Weilv-D/kuafu/docs/architecture/system.md

# System Architecture

## Control Partition

The STM32 owns safety-critical stabilization as a deadline-bounded bare-metal runtime; the Pi5 runs an ONNX Actor at 50 Hz and supplies bounded residual actions. The Actor never replaces the baseline controller. The two exchange a shared contract — Pi5 commands velocity/yaw/D0 plus six normalized residuals, STM32 returns timestamped IMU, joint, and health telemetry — defined in full in `docs/contracts/interface.md`.

```text
high-level command (Pi5)
  -> jerk/acceleration-limited references
  -> STM32 baseline: position, velocity, pitch, heading, roll, IK
  <- Pi5 Actor: bounded common/yaw torque and Qx/D0 residuals
  -> wheel/servo commands
```

The runtime runs on four deadline-bounded layers. Layers 1–3 are paced by the
1 kHz BMI088 gyro data-ready tick; layer 4 is paced by the SysTick wall clock
so that an IMU-path failure never silences diagnostics:

1. **1 kHz IMU layer** — BMI088 sampling and Mahony attitude fusion, never waiting on actuator buses.
2. **250 Hz safety-control layer** — snapshots the newest valid sensor and command state, runs the state machine, then LQR/LQI with reference tracking, yaw heading/rate tracking, and roll leveling.
3. **50 Hz leg/Pi layer** — projects Qx/D0 residuals through five-bar IK onto ST3215 targets, parses Pi traffic, and publishes fusion-state telemetry (IMU/joint frames).
4. **Wall-clock diagnostic layer** — reports fault masks, temperatures, per-device bus ages, error counters, reset cause, and safety mode (250 Hz diagnostic frames, 10 Hz health frames, FAULT frames while latched), independently of the data-ready tick and of IMU health.

A separate `startup_manager` gates actuator power through `WAIT_POWER → IMU_DISCOVERY → ACTUATOR_DISCOVERY → READY` (with a `FAILED` terminal that latches FAULT); gyro bias calibration is deliberately **not** a startup gate — it accumulates in the background while the robot stands, because a zero bias is a valid autonomous STAND starting point. Torque is never enabled merely because initialization began; the system reaches STAND only once every device reports fresh. Wheel torque is a separately armed domain with three baseline conditions — the system operational (STAND/ACTIVE/CLIMB, so INIT keeps the wheels locked to read-only queries), startup READY, and no latched fault — whose loss is immediately revoked; this is independent of the Pi so standalone STAND balance works with no Pi attached. Entering ACTIVE additionally requires a compatible Pi model hash, a fresh heartbeat, and an explicit mode request.

Ten independent fault classes (tilt, pitch rate, overtemperature with 100 ms debounce, IMU loss, left/right wheel loss, servo loss, emergency stop, initialization failure, internal-state fault) latch `FAULT`. They split into two recovery families: **serious** faults (tilt, pitch rate, overtemperature, IMU loss, emergency stop, initialization failure, internal fault) stay latched until power cycle, while the three **transient device faults** (left/right wheel loss, servo loss) auto-recover once the device reports fresh again — recovery re-enters STAND through the supervisor's re-issue stage, which physically re-runs the servo torque enables and requires a transmitted leg hold before wheel output returns. Degradation short of a fault is explicitly asymmetric: a stale action clears only the learned residual, while a stale heartbeat additionally zeroes velocity and yaw commands and returns ACTIVE/CLIMB to STAND, retaining a bounded local position/heading hold so the robot stays still rather than falling.

### Operating Modes

The state machine distinguishes five modes (`INIT`, `STAND`, `ACTIVE`, `CLIMB`, `FAULT`). The LQR/LQI baseline runs whenever the system is operational (STAND/ACTIVE/CLIMB); what changes between them is whether the Pi commands motion and whether the learned residual is added:

| Mode | Wheel torque | Leg D0 (IK) | RL residual | Entered by |
|---|:---:|:---:|:---:|---|
| `INIT` | locked (read-only queries) | — | — | power-on; auto-exits when every device is fresh |
| `STAND` | LQR/LQI **hold** (zero velocity/yaw command) | follows `target_leg_d0` | off | auto, once startup reaches `READY` |
| `ACTIVE` | **LQR/LQI tracking** (follows Pi velocity/yaw) | follows `target_leg_d0` + qx/d0 residual | **on** | Pi requests ACTIVE + compatible hash + fresh heartbeat |
| `CLIMB` | LQR/LQI **hold** (zero velocity/yaw command) | follows `target_leg_d0` | off | Pi requests CLIMB from ACTIVE |
| `FAULT` | zero | torque disabled (one-shot) | — | any fault; transient device faults auto-recover (servo enables re-issued first), serious faults latch until reset |

`ACTIVE` is the only mode in which the learned residual is live, so it is the only mode in which the robot walks. The policy observation is 35-dimensional proprioception with no mode flag; the policy is unaware which mode it runs in, and CLIMB/STAND behaviour comes entirely from the baseline.

A mode request that names a mode the firmware cannot enter is never silently dropped: from a walking mode (`ACTIVE`/`CLIMB`) an `INIT` request is honoured as `STAND`. `INIT` is a boot state with no inbound transition, so a sender that asks for it while the robot moves is asking the robot to stop, and the mode on both sides of the link must agree about that. `CLIMB` stays reachable only through the `ACTIVE` arming step, so a `CLIMB` request from `STAND` leaves the robot holding.

> **`CLIMB` is a reserved placeholder, not a distinct behaviour.** In the firmware it shares the same code path as `STAND` (same pure-D0 IK, same wheel hold, no residual — `main.c` servos the identical virtual-height branch for both). The RL environment has no CLIMB concept: terrain traversal (steps and slopes) is trained as a curriculum axis under the ACTIVE policy using D0/Qx residuals, and the policy never emits or observes a mode. Selecting CLIMB today is therefore functionally equivalent to STAND. A future CLIMB implementation would need coordinated changes in firmware (a distinct servo/wheel policy for the mode), training (a mode-conditioned or separate policy), and the Pi runtime.

Roll leveling applies `ΔD0 = -ROLL_KP·roll - ROLL_KD·ωx` with `ROLL_KP = 190 mm/rad` and `ROLL_KD = 5.0`, a conservative initial value derived from the ~196 mm wheel track. A high-speed D0 gate limits D0 to 120 mm whenever `|v| > 0.3 m/s` or `|w| > 0.6 rad/s`, preventing COM-rise topple. LQR/LQI gains, wheel torque limits, five-bar geometry, and the full normative physical model live in `kuafu_physics.py`; the implementation-level runtime, driver, and safety detail lives in `stm32_firmware/README.md`.

## Learning Partition

The Actor receives four causal 35-dimensional proprioceptive frames, for a 140-dimensional input. Forward velocity and yaw rate come from wheel-odometry estimates, not simulation root truth. Every input has a sensor or estimator counterpart on real hardware. The `prev_applied_action` field carries the delayed action actually sent to actuators, so the policy observes the true effect of its previous output. A training Critic receives the Actor input plus 12 simulation-only values: nine static domain-randomization parameters and the three-dimensional applied push.

Friction domain randomization samples actual coefficients in `[0.3, 1.2]`. Push perturbation uses impulse-based sampling of 0-2 N·s with random timing. The first-frame history on reset is `[0, 0, 0, current]`, seeding the causal window with a valid current observation.

## Policy And Projection

The policy is a reparameterized tanh-squashed diagonal Gaussian:

```text
u ~ Normal(mu, sigma)
a = tanh(u)
log p(a) = log Normal(atanh(a); mu, sigma) - sum(log(1-a^2))
```

The Jacobian term `-log(1-a^2)` is included in `log_prob`, ensuring unbiased PPO ratios and entropy. PPO sampling, deterministic inference, ONNX, and Pi5 use this same transformation. PPO uses `init_noise_std = 0.4`, `gamma = 0.995`, and `num_steps_per_env = 96`. The six bounded actions are projected as common wheel torque, yaw wheel torque, left Qx, left D0, right Qx, and right D0. Qx and D0 are independently mapped through a two-dimensional five-bar IK grid.

## Curriculum

Training drives an 8-axis independent curriculum state machine (`rl/train/curriculum.py`): `command, d0, dr, latency, slope, step, rough, push`. Each axis has independent levels (0-4), evaluated by done-env episode count. Terrain/perturbation axes advance on a pure survival gate; only `command`/`d0` add a tracking anti-cheat gate calibrated to the physical noise floor, so a policy that remains still cannot pass the gate but terrain progress is never blocked on velocity tracking. An axis advances when survival (and, for command/d0, tracking) passes for two consecutive evaluations and regresses on two consecutive failures. Rough terrain is a MuJoCo heightfield rewritten each reset.

## Simulation

MJX advances ten 2 ms physics steps for each policy step. The five 4 ms base updates recompute LQR/LQI wheel torque while holding the policy residual. Native MuJoCo evaluation must use the same command projection and timing before it can be considered a release result.
