Weilv-D/kuafu/CHANGELOG.md

# Changelog

## Unreleased

### Firmware logic review, fifth record (2026-09-20)

An independent eighth-pass, whole-repository review performed from source
alone (the seven prior records consulted only afterwards to cross-check;
their invariants held, and one encoded test expectation was found to pin a
defect). Three findings, all closed in this round.
Record: `docs/validation/stm32-firmware-2026-09-20-5.md`.

- (High) The Pi RX transport recovers from a ring overrun instead of
  stalling one ring behind the producer forever. `pi_transport_poll` derived
  its parse span from a read-index-vs-write-index comparison; after the
  overrun drop the two indices coincide while a full ring is still pending,
  so the poll parsed nothing and every later byte was billed as a fresh
  overrun — the receive side of the Pi link stayed deaf until reboot after
  any main-loop stall longer than one ring (~2.2 ms at 921600 baud). The
  span now comes from the absolute produced/consumed cursors (clamped to one
  ring), the still-valid remainder is parsed in the same poll, and the
  laps/NDTR sampling race is harmless by construction (a stale sample can
  only under-advance the producer for one poll; `consumed` can never
  overshoot `producer`). Regressions in `test_pi_transport.c` (new overrun-
  recovery suite) and one corrected wrap-case expectation in
  `test_pi_link.c`.
- (Medium) The balance trace's post-fault freeze is releasable. Previously
  the first fault — including an auto-recovered transient wheel/servo
  freshness blip — froze the 256-sample ring for the rest of the session, so
  a later crash's window was never recorded. The freeze now releases when a
  new fault arrives after a fault-free period (the newer evidence supersedes
  the preserved window) or once the system has been fault-free for a full
  64-sample tail; a latched serious fault keeps the ring frozen by design.
  Two new file-scope statics (+4 bytes RW) shifted 11 SWD symbol addresses
  by a uniform +4; the `HANDOFF.md` §5.2 table and the three hardcoded
  debug-script ADDR dictionaries were rebased. Regression in
  `test_balance_trace.c`.
- (Low) `lqr_update_elapsed_dt` coasts on any non-finite input instead of
  propagating NaN through the gains into the torque output (NaN compares
  false against every clamp bound, and the dispatch clamps only bound
  magnitude). Unreachable through the current call chain; the guard is for
  future callers, matching `ddsm_build_torque`/`quantize_i16`/
  `servo_angle_to_tick`. Regression in `test_lqr.c`.

### Firmware logic review, fourth record (2026-09-20)

An independent sixth-pass, whole-repository review performed from source
alone (the five prior records consulted only afterwards to cross-check;
nothing in them was stale). Three findings, all closed in this round.
Record: `docs/validation/stm32-firmware-2026-09-20-4.md`.

- (Medium) The firmware receive sequence gate now resynchronizes after a
  peer restart, mirroring the Pi-side decoder's 8-frame resync: eight
  consecutive CRC-valid, non-HELLO frames rejected by the monotonic gate
  alone clear the baseline and the next frame starts a new session. Every
  Pi-side program sends HELLO exactly once at startup, so a single
  corrupted HELLO previously locked a rebooted Pi out of `ACTIVE` until
  its counter climbed back past the previous session's high-water mark —
  minutes at 50 Hz, clearing only on an STM32 power cycle. Payload-invalid
  frames never count (noise cannot open the gate), and any accepted frame
  clears the streak, so isolated duplicates are still dropped. The reject
  counter is packed into the existing `have_rx_sequence` state byte, so
  the SWD debug-symbol table is unchanged. Regression in `test_pi_link.c`.
- (Low) `ddsm_build_torque`/`ddsm_build_speed` decode a non-finite command
  as zero (coast) instead of reaching an undefined float→int cast — a NaN
  compares false against every clamp bound. Unreachable through the
  current call chain (finiteness is validated upstream in the same control
  deadline); the guard is for future callers of the public encoders, the
  same latent-trap class as `quantize_i16`. Regression in
  `test_ddsm315.c`.
- (Low) `servo_angle_to_tick` maps a non-finite angle to the calibrated
  dwell tick instead of the same undefined cast — never a mechanical
  extreme, which a clamp would command. Regression in
  `test_servo_mapping.c`.

### Firmware logic review, third record (2026-09-20)

An independent fifth-pass review performed from source alone (prior
records consulted only afterwards to re-verify their invariants; all held).
Six findings, all closed in this round. Record:
`docs/validation/stm32-firmware-2026-09-20-3.md`.

- (Medium) Both ST3215 write-frame failure paths — a lost TX-complete
  interrupt and a UART error during the write — recover through the same
  explicit transmit abort before the bus returns to IDLE. An error storm is
  precisely when completion interrupts go missing; either path skipping the
  abort can wedge the HAL transmit state at `BUSY_TX` forever (all leg
  writes fail `HAL_BUSY`, the 100 ms leg-hold window expires, the wheel
  gate closes, and the 20 ms deadline backstop is disarmed because phase is
  already IDLE). Regression in `test_st3215.c`.
- (Medium-low) Circular RX-ring re-arms preserve the lap truth: new
  `dma_rx_ring_rebase()` anchors the consumer at the current lap boundary
  while keeping every counted lap and the cumulative overrun diagnostic —
  the same semantics `pi_transport_reset` already implements (the
  synchronous abort completes the old stream, so a racing lap is real).
  The ring is also initialised before the peripheral that starts its DMA.
  A lost or invented lap skews the producer cursor by up to one ring and
  re-feeds overwritten bytes to the parser as spurious checksum failures.
  Regression in `test_dma_rx_ring.c`.
- (Medium-low) Diagnostic, health, and FAULT telemetry ride the SysTick
  wall clock (250 Hz diag, 10 Hz health, FAULT while latched) instead of
  the gyro data-ready tick: an IMU-path failure no longer silences the
  frames that diagnose it. Fusion-state telemetry (IMU/joints) stays
  DRDY-gated — frozen fusion output has no value, and the health frame's
  age fields carry that information. The cadence divider is a `main()`
  stack local, so the SWD symbol table is unchanged.
- (Low) `balance_trace_init()` seeds the first recorded sample with the
  INIT boot marker (the event type existed; nothing produced it).
- (Low) Telemetry quantization returns the zero sentinel for non-finite
  inputs instead of an undefined float-to-int cast; finite encodings are
  unchanged. Regression in `test_pi_link.c`.
- (Low) `pi_link_on_tx_error` carries the `tx_active` guard its completion
  twin has, so an error arriving while nothing of ours is transmitting
  cannot pop a merely queued telemetry frame.

### Firmware logic review, second pass (2026-09-20)

An independent fourth-pass review layered on the 09-20 three-pass baseline
(architecture and every module re-derived from source before the prior
records were consulted). Record: `docs/validation/stm32-firmware-2026-09-20-2.md`.

- Wheel dispatch no longer leaves torque latched in the DDSM315 current
  loop when the output gate closes on a still-enabled wheel: an explicit
  zero-torque frame is sent in any mode (previously only `FAULT`; other
  gate-closed states sent a read query, and the motor kept driving the
  pre-closure LQR torque — reachable via a supervisor HOLDING demotion
  while the mode stayed operational, e.g. the 100 ms leg-hold window
  expiring under servo-bus congestion — until the 45° TILT backstop).
  Torque frames elicit the same status reply as queries, so feedback
  freshness is unchanged in every branch. New regression in
  `test_ddsm315.c` pins the zero-frame encoding and the reply channel.
- `SERVO_FAIL_LIMIT` comment corrected: it is the round-robin poll's
  `offline_after` (3 consecutive read failures mark a servo offline), not a
  fatal-FAULT latch; fault latching belongs to the safety layer's freshness
  path.
- Documented as deliberate (no code change): telemetry is silent while the
  IMU path is down (slots live in the DRDY-gated fusion block — SWD-only
  forensics in that state); the DDSM feedback mode byte is diagnostic-only
  (no runtime re-assert verification); the LQR position estimate freezes
  during gate-closed periods (≤ one 20 ms catch-up step, ~4 cm worst-case
  `x_est` bias for a 100 ms demotion).
- Documentation: HANDOFF repository path updated after the workspace move;
  the dispatch policy is now stated wire-accurately in the safety-gating
  section; this changelog gained the previously missing 09-20 three-pass
  entry below.

### Firmware logic review (2026-09-20, three passes)

Full-codebase review layered on the 09-13/09-16 baselines: two review
passes (the second re-verifying the first's fixes via byte-level echo-filter
traces, FAULT bus-queue priority, a UB audit, and an NVIC priority audit)
plus a closeout pass. 10 defects fixed (1 high, 5 medium, 4 low). Record:
`docs/validation/stm32-firmware-2026-09-20.md`.

- (High) The servo enable sequencer was mode-blind: during `FAULT` it fought
  the 50 Hz one-shot torque-disable (~80 ms enable/disable churn) and re-set
  `servos_enabled`, so a transient-fault recovery could clear the
  supervisor's re-issue stage on the racing 0→1 and reopen the wheel gate on
  physically torque-free legs. The sequencer is now gated on
  `mode != FAULT`, giving the supervisor the genuine drop-and-return its
  re-issue stage requires.
- (Medium) The DDSM bus timeout verdict is re-validated under the IRQ mask
  against phase and deadline, closing the one main-context phase transition
  the concurrency contract left uncovered (a stale verdict could kill a
  transaction the completion ISR had just started).
- (Medium) ST3215 write frames (sync-write/torque) carry a 20 ms deadline
  and recover through an explicit `AbortTransmit`, so a lost TX-complete
  interrupt costs one frame instead of wedging the servo bus until a
  freshness fault.
- (Medium) Servo freshness requires a real first feedback frame: the
  boot-time optimistic online flag could make a never-replied servo look
  fresh for the first second, briefly opening the wheel gate on legs whose
  feedback had never been seen.
- (Medium, bench builds only) The two calibration images latch `FAULT_INIT`
  (serious) in addition to the transient diagnostic bits: a transient bit
  alone auto-recovers to STAND within seconds of the freshly polled devices
  reporting fresh, re-arming actuation on an image that must stay
  torque-free.
- (Medium) The 1 kHz tick block's deep `continue` became an explicit
  `if (g_imu.initialized)` guard — the `continue` silently skipped every
  scheduler stage below it (50 Hz legs, servo poll), coupling them to IMU
  init state.
- (Low) `pi_link` critical sections restore the saved PRIMASK instead of a
  bare `__enable_irq()`; `bmi088_read_temp` gained the handle guard its
  sibling readers have; `queued_mode` no longer records an enable frame's
  CRC as a control mode; the retired `STARTUP_GYRO_CALIBRATION` enum member
  was deleted (numeric gap kept for trace-encoding stability) and dead
  declarations clarified.

### Firmware & Pi5-runtime logic review (2026-09-16)

- The freshness-fault grace window (100 ms + stale-counter reset) is now
  granted only by device-driven mode transitions (INIT->STAND, FAULT->STAND
  recovery). Command-driven transitions (mode requests, link-loss demotion)
  previously reset the counters too, so a Pi flapping `mode_request` at
  >10 Hz could suppress wheel/servo loss faults indefinitely while the
  wheels stayed enabled.
- The 50 Hz leg-write deadline is no longer dropped when the ST3215 bus is
  busy: the pending flag survives until a frame is actually queued (or the
  mode has nothing to send), retried on the next scheduler pass — the same
  retry shape the wheel dispatch always had. Five bus-busy collisions used
  to expire the 100 ms leg-hold window and close the wheel gate (~100 ms of
  zero torque on a balancing robot); with one degraded servo this recurred
  regularly. `firmware_runtime.servo_intent_allowed` is now a pure
  mode-level verdict, symmetric with `wheel_intent_allowed`.
- `teleop_single` mirrors the firmware's dynamic D0 gate before encoding:
  raising the legs and pushing the stick fast used to fail validation every
  tick, silencing the heartbeat stream exactly during aggressive motion
  until the 200 ms watchdog demoted the robot. The TX error path now falls
  back to a safe STAND heartbeat instead of silence, a lost gamepad no
  longer replays its last stick values, a blocking BLE reconnect first
  forces disarm, and the exit ESTOP is flushed before close.
- The Pi-side `StreamDecoder` resynchronizes after a peer sequence restart
  (STM32 reboot restarts its TX counter at 0): 8 consecutive CRC-valid
  sequence-gated rejections clear the high-water mark. Previously every
  telemetry frame was blackholed until the rebooted counter climbed past
  the stored value. Isolated duplicates are still dropped.
- `serial_node` keeps the heartbeat contract with an explicit safe request
  (STAND, zero commands) when telemetry is stale instead of going silent,
  and resets the observation history when telemetry resumes.
- `link_probe` fault-bit table realigned with `safety_state.h` (it was
  shifted one bit — FAULT_SERVO printed as WHEEL_L_LOST); FAULT frames are
  now counted and printed, `--mode` is validated, HEALTH payloads are
  length-guarded, the loop re-clamps its deadline after a stall, and the
  exit ESTOP is flushed.
- Diag telemetry saturates the temperature into the uint8 field (a negative
  BMI088 reading was an undefined float-to-unsigned cast).
- Removed the dead `gyro_calibrated` input plumbing from
  `SafetyInputs_t`/`StartupInputs_t`/`ControlSectionInputs_t` (never
  consumed anywhere; gyro calibration is documented as a non-gate).

### Firmware logic review (2026-09-13)

- Fixed an initial-power-on deadlock in the actuator supervisor's ops-less
  enable-reissue stage: the scheduler couples `startup_ready` and
  `servo_enable_verified` to the same sequencer variable, so the verified flag
  is never observed low while `startup_ready` is high, and the unconditional
  clearing of `enable_verified_observed_low` on every STARTUP/HOLDING entry
  discarded the boot-time low observations. The wheel-output gate could never
  open from a clean boot (only a prior FAULT cycle unblocked it). Low-state
  observations are now latched on every step, and the drop-requirement is
  re-armed only when a revocation follows an authorized (READY) state;
  transient leg-readiness gaps no longer re-arm it.
- Wheel enable no longer occurs while the safety mode is still `INIT`; the
  wheel power domain stays locked to read-only queries until STAND, matching
  the documented mode table.
- ST3215 UART error handling is deferred from the error ISR to the main-loop
  bus step, eliminating an interrupt-context race on the transaction pointer,
  phase, parser, and health counters (the DDSM driver already used locking;
  this bus now uses deferral).
- The 64-byte RAM-top forensic dump area (`STALL_DUMP` + `FAULT_DUMP`) is now
  excluded from the linker layout (IRAM2 ends at `0x2001FFBF`), so future RAM
  growth can never collide with the reset-surviving dumps.
- LQR estimation authority now additionally requires IMU pair freshness, so a
  dead gyro data-ready line (which freezes `g_imu_control_valid` at its last
  value) revokes torque at the 20 ms freshness bound instead of the ~52 ms
  freshness-fault debounce.
- Removed the unconsumed `firmware_runtime.clear_motion` output (motion
  clearing is owned by the safety state machine) and duplicate dead
  trace-validity defines in `main.c`.
- Documentation aligned: schema references updated to `v1.2.0`, the startup
  chain no longer lists the unused GYRO_CALIBRATION phase, the wheel-domain
  gating text matches the standalone-STAND design, and stale DDSM timeout /
  debounce numbers corrected (12 ms / 8 ticks).

### Control and contract

- Versioned 140-dimensional Actor / 152-dimensional Critic contract at schema `v1.1.0`, with a tanh-squashed policy transform shared by PPO, ONNX export, and the Pi5 runtime.
- Source-generated discrete LQR/LQI firmware constants, dwell-relative five-bar IK generation, and versioned UART framing with CRC-8/MAXIM.
- High-speed D0 gate (120 mm cap when `|v| > 0.3 m/s` or `|w| > 0.6 rad/s`) and roll leveling (`ROLL_KP = 190 mm/rad`, `ROLL_KD = 5.0`).

### Firmware

- STM32F407ZG bare-metal runtime: 1 kHz IMU fusion, 250 Hz LQR/LQI baseline, five-bar workspace projection.
- Self-balancing in STAND mode works standalone (no Pi required): wheel torque authorization is gated on startup completion and absence of fault, independent of Pi link or heartbeat freshness. The Pi link gates ACTIVE motion commands only.
- LQR control runs every 250 Hz deadline regardless of DDSM bus state; the dispatch layer skips transmission when the bus is busy so the controller is never starved.
- DDSM115 speed feedback decoded in 0.1 RPM units matching the command encoding.
- DDSM transaction timeout set to 12 ms and freshness-fault debounce to 8 ticks to accommodate marginal RS485 links without spurious FAULT_WHEEL.
- Right DDSM315 motor is physically mirrored: `WHEEL_DIR_R = -1` and the LQR yaw-differential formula is adapted so forward torque + positive yaw produce a correct right turn.
- DDSM315 torque polarity is opposite to the cart-pole convention; LQR output is negated accordingly.
- Pitch-gated torque fade (20°→50° linear) prevents wheels spinning at full power when the robot is beyond recoverable tilt; anti-windup zeros the position integral at 50°.
- Wheel dispatch streams zero-torque frames whenever the output gate is
  closed on an enabled wheel (any mode), ensuring the current loop actually
  stops instead of holding its last setpoint; read queries are used only
  while the wheels are disabled.
- BMI088 initialization retries with I2C bus recovery (9 SCL clocks per AN3273) on failure; a soft reset no longer requires a power-cycle for the IMU to come online.
- USART ORE/NE/FE sub-error diagnostics surfaced in DeviceHealth for SWD readout; the 46-byte health telemetry payload is unchanged.
- Pi link auto-accepts the first well-formed heartbeat as proof of protocol compatibility when no explicit HELLO has been received.

### Teleop

- Two-state arm/disarm safety model: sources start DISARMED (firmware STAND, balance held, no motion commands) and require an explicit arm action before the wheels track commands.
- Stick input shaping (deadzone then square curve) and trigger deadzones; full STAND/ACTIVE/FAULT intent carried end to end over the wire.
- Gamepad hot-plug and haptic feedback on state transitions.
- ``--no-policy`` mode for baseline-only operation: skips ONNX loading, sends zero
  residual, requires no ``policy.onnx`` or manifest. Usable with or without teleop.

### Runtime and tests

- Pi5 ONNX Actor loop with manifest, schema, and calibration-table digest validation.
- Release-gate validation, atomic schema-aware checkpoints with CPU-first loading.
- Host test suites: firmware C tests (CMake), teleop Python tests, and contract tests.
- Documentation reorganized around architecture, contracts, operations, validation, and hardware calibration.

### Compatibility

- Schema `v1.0.0` checkpoints (157-dimensional RMA) are `legacy-v0` and cannot be resumed, exported, or deployed.
