Weilv-D/kuafu/stm32_firmware/MDK-ARM/debug_tools/read_health.py

"""Read firmware health records over SWD without writing target memory."""

import argparse
import re
import struct
import time
from pathlib import Path

PROBE = "LU_2022_8888"
TARGET = "stm32f407zgtx"
MAP_PATH = Path(__file__).resolve().parents[1] / "stm32_firmware" / "stm32_firmware.map"


def symbol_address(name: str) -> int:
    text = MAP_PATH.read_text(encoding="utf-8", errors="replace")
    match = re.search(rf"^\s+{re.escape(name)}\s+(0x[0-9a-fA-F]+)\s+Data\b", text, re.MULTILINE)
    if match is None:
        raise RuntimeError(f"cannot find {name} in {MAP_PATH}")
    return int(match.group(1), 16)


def decode_health(data: bytes, offset: int) -> dict[str, int]:
    last, timeout, checksum, protocol, overrun, noise, framing, consecutive, online = \
        struct.unpack_from("<IHHHHHHBB", data, offset)
    return {"last": last, "timeout": timeout, "checksum": checksum,
            "protocol": protocol, "consecutive": consecutive, "online": online,
            "overrun": overrun, "noise": noise, "framing": framing}


def main() -> None:
    parser = argparse.ArgumentParser(description="Read-only KUAFU firmware health over DAPLink")
    parser.add_argument("--samples", type=int, default=5)
    parser.add_argument("--interval", type=float, default=0.5)
    parser.add_argument("--frequency", type=int, default=100_000)
    parser.add_argument("--under-reset", action="store_true",
                        help="explicitly reset during attach; default attaches without reset")
    args = parser.parse_args()

    from pyocd.core.helpers import ConnectHelper

    addresses = {name: symbol_address(name) for name in
                 ("g_system_ticks", "uwTick", "g_imu", "g_ddsm_left", "g_ddsm_right", "g_servos", "g_safety_state", "g_startup_manager", "g_actuator_discovery_step", "g_actuator_configured")}
    addresses["g_st3215_bus"] = symbol_address("g_st3215_bus")
    addresses["huart3"] = symbol_address("huart3")
    addresses["g_ddsm_bus"] = symbol_address("g_ddsm_bus")
    addresses["huart2"] = symbol_address("huart2")
    addresses["hi2c1"] = symbol_address("hi2c1")
    session = ConnectHelper.session_with_chosen_probe(
        blocking=False, unique_id=PROBE, target_override=TARGET, frequency=args.frequency)
    if session is None:
        raise SystemExit("DAPLink probe not found")
    if args.under_reset:
        session.options.set("connect_mode", "under-reset")
    session.open()
    try:
        session.target.resume()
        for _ in range(args.samples):
            # Halt only for the SWD snapshot so all timestamps share one timebase;
            # resume before printing/sleeping to avoid disturbing the watchdog.
            session.target.halt()
            tick = session.target.read32(addresses["g_system_ticks"])
            mode = session.target.read8(addresses["g_safety_state"])
            fault = session.target.read32(addresses["g_safety_state"] + 12)
            startup = bytes(session.target.read_memory_block8(addresses["g_startup_manager"], 12))
            actuator_step = session.target.read8(addresses["g_actuator_discovery_step"])
            actuator_configured = session.target.read8(addresses["g_actuator_configured"])
            imu = bytes(session.target.read_memory_block8(addresses["g_imu"], 0x34))
            left = bytes(session.target.read_memory_block8(addresses["g_ddsm_left"], 0x28))
            right = bytes(session.target.read_memory_block8(addresses["g_ddsm_right"], 0x28))
            servos = bytes(session.target.read_memory_block8(addresses["g_servos"], 4 * 0x34))
            servo_bus = bytes(session.target.read_memory_block8(addresses["g_st3215_bus"], 0x138))
            uart3 = bytes(session.target.read_memory_block8(addresses["huart3"], 0x44))
            wheel_bus = bytes(session.target.read_memory_block8(addresses["g_ddsm_bus"], 0x24))
            uart2 = bytes(session.target.read_memory_block8(addresses["huart2"], 0x44))
            i2c1 = bytes(session.target.read_memory_block8(addresses["hi2c1"], 0x54))
            hal_tick = session.target.read32(addresses["uwTick"])
            records = [("imu", decode_health(imu, 0x20)),
                       ("wheel_l", decode_health(left, 0x14)),
                       ("wheel_r", decode_health(right, 0x14))]
            records += [(f"servo_{i + 1}", decode_health(servos, i * 0x34 + 0x20)) for i in range(4)]
            session.target.resume()
            print(f"drdy_tick={tick} hal_ms={hal_tick} mode={mode} fault=0x{fault:08x}")
            startup_phase, startup_since, startup_next = struct.unpack_from("<III", startup)
            print(f"  startup  phase={startup_phase} since_ms={startup_since} next_ms={startup_next} "
                  f"actuator_step={actuator_step} configured={actuator_configured}")
            accel = struct.unpack_from("<3f", imu, 0x04)
            gyro = struct.unpack_from("<3f", imu, 0x10)
            print(f"  bmi088   initialized={imu[0x31]} init_state={imu[0x30]} "
                  f"temp_c={struct.unpack_from('<f', imu, 0x1C)[0]:.1f} "
                  f"accel=({accel[0]:.3f},{accel[1]:.3f},{accel[2]:.3f}) "
                  f"gyro=({gyro[0]:.4f},{gyro[1]:.4f},{gyro[2]:.4f})")
            print(f"  i2c1     state=0x{i2c1[0x3D]:02x} mode=0x{i2c1[0x3E]:02x} "
                  f"error=0x{struct.unpack_from('<I', i2c1, 0x40)[0]:08x} "
                  f"device=0x{struct.unpack_from('<I', i2c1, 0x44)[0]:02x}")
            print(f"  st_bus   phase={servo_bus[0x134]} tx_len={servo_bus[0x68]} "
                  f"echo={servo_bus[0xC9]} frame={servo_bus[0x12A]}/{servo_bus[0x12B]} "
                  f"rx=0x{servo_bus[0x12C]:02x} uart_rx_left={struct.unpack_from('<H', uart3, 0x2E)[0]} "
                  f"uart_state=0x{uart3[0x3E]:02x} uart_error=0x{struct.unpack_from('<I', uart3, 0x40)[0]:08x}")
            print(f"  ddsm_bus phase={wheel_bus[0x20]} target=0x{struct.unpack_from('<I', wheel_bus, 4)[0]:08x} "
                  f"rx={wheel_bus[0x12:0x1C].hex()} uart_rx_left={struct.unpack_from('<H', uart2, 0x2E)[0]} "
                  f"uart_state=0x{uart2[0x3E]:02x} uart_error=0x{struct.unpack_from('<I', uart2, 0x40)[0]:08x}")
            for name, health in records:
                age = "never" if health["last"] == 0 else str((hal_tick - health["last"]) & 0xFFFFFFFF)
                errors = health["timeout"] + health["checksum"] + health["protocol"]
                uart_sub = ""
                if name.startswith("wheel"):
                    uart_sub = (f" overrun={health['overrun']} noise={health['noise']} "
                                f"framing={health['framing']}")
                temp = ""
                if name.startswith("servo_"):
                    index = int(name[-1]) - 1
                    temp = f" temp_c={struct.unpack_from('<f', servos, index * 0x34 + 0x10)[0]:.1f}"
                print(f"  {name:8s} online={health['online']} age_ms={age:>5} "
                      f"errors={errors} consecutive={health['consecutive']}{uart_sub}{temp}")
            time.sleep(args.interval)
    finally:
        session.close()


if __name__ == "__main__":
    main()
