Weilv-D/kuafu/stm32_firmware/tests/test_safety_state.c

#include "pin_config.h"
#include "safety_state.h"
#include "test_support.h"

#include <math.h>
#include <string.h>

static SafetyInputs_t healthy_inputs(void) {
    SafetyInputs_t inputs;
    memset(&inputs, 0, sizeof(inputs));
    inputs.now_ms = 100U;
    inputs.startup_ready = 1U;
    inputs.imu_fresh = 1U;
    inputs.wheel_l_fresh = 1U;
    inputs.wheel_r_fresh = 1U;
    inputs.servos_fresh = 1U;
    inputs.link_compatible = 1U;
    inputs.heartbeat_fresh = 1U;
    inputs.action_fresh = 1U;
    inputs.requested_mode = STATE_STAND;
    return inputs;
}

static void enter_stand(SafetyInputs_t *inputs) {
    safety_state_init();
    (void)safety_state_update(inputs);
    TEST_EQ_INT(STATE_STAND, g_safety_state.current_mode);
}

static void expect_immediate_fault(SafetyInputs_t inputs, FaultMask_t fault) {
    SafetyInputs_t healthy = healthy_inputs();
    SafetyDecision_t decision;
    enter_stand(&healthy);
    decision = safety_state_update(&inputs);
    (void)decision;
    TEST_EQ_INT(STATE_FAULT, g_safety_state.current_mode);
    TEST_TRUE((g_safety_state.fault_mask & fault) != 0U);
}

static void expect_freshness_fault_after_debounce(SafetyInputs_t inputs,
                                                  FaultMask_t fault) {
    SafetyInputs_t healthy = healthy_inputs();
    enter_stand(&healthy);

    /* Move past the mode-transition grace window so the debounce logic is
     * actually exercised. */
    inputs.now_ms = g_safety_state.mode_grace_until_ms + 1U;

    /* One stale tick does NOT latch. */
    (void)safety_state_update(&inputs);
    TEST_EQ_INT(STATE_STAND, g_safety_state.current_mode);
    TEST_TRUE((g_safety_state.fault_mask & fault) == 0U);

    /* Repeat until just before the debounce threshold. */
    for (uint8_t i = 1U; i < SAFETY_FRESHNESS_DEBOUNCE_TICKS - 1U; ++i) {
        inputs.now_ms += 4U;
        (void)safety_state_update(&inputs);
        TEST_EQ_INT(STATE_STAND, g_safety_state.current_mode);
    }

    /* One more stale tick at the threshold latches. */
    inputs.now_ms += 4U;
    (void)safety_state_update(&inputs);
    TEST_EQ_INT(STATE_FAULT, g_safety_state.current_mode);
    TEST_TRUE((g_safety_state.fault_mask & fault) != 0U);
}

void run_safety_state_tests(void) {
    SafetyInputs_t inputs = healthy_inputs();
    SafetyDecision_t decision;

    enter_stand(&inputs);
    inputs.requested_mode = STATE_ACTIVE;
    decision = safety_state_update(&inputs);
    TEST_EQ_INT(STATE_ACTIVE, g_safety_state.current_mode);
    TEST_TRUE(!decision.enter_hold);

    inputs.action_fresh = 0U;
    decision = safety_state_update(&inputs);
    TEST_TRUE(decision.clear_action);
    TEST_EQ_INT(STATE_ACTIVE, g_safety_state.current_mode);

    inputs.heartbeat_fresh = 0U;
    decision = safety_state_update(&inputs);
    TEST_TRUE(decision.enter_hold);
    TEST_EQ_INT(STATE_STAND, g_safety_state.current_mode);

    inputs = healthy_inputs(); inputs.pitch_rad = SAFETY_MAX_PITCH_RAD + 0.01f;
    expect_immediate_fault(inputs, FAULT_TILT);
    inputs = healthy_inputs(); inputs.pitch_rate_rads = SAFETY_MAX_PITCH_RATE_RAD_S + 0.01f;
    expect_immediate_fault(inputs, FAULT_PITCH_RATE);
    TEST_TRUE((safety_state_legacy_fault_mask() & 0x80U) != 0U);
    inputs = healthy_inputs();
    enter_stand(&inputs);
    inputs.max_temp_c = SAFETY_MAX_TEMP_C + 1.0f;
    inputs.now_ms = 200U;
    (void)safety_state_update(&inputs);
    TEST_EQ_INT(STATE_STAND, g_safety_state.current_mode);
    inputs.now_ms = 299U;
    (void)safety_state_update(&inputs);
    TEST_EQ_INT(STATE_STAND, g_safety_state.current_mode);
    inputs.now_ms = 300U;
    (void)safety_state_update(&inputs);
    TEST_EQ_INT(STATE_FAULT, g_safety_state.current_mode);
    TEST_TRUE((g_safety_state.fault_mask & FAULT_OVERTEMP) != 0U);
    inputs = healthy_inputs(); inputs.imu_fresh = 0U;
    expect_freshness_fault_after_debounce(inputs, FAULT_IMU);
    inputs = healthy_inputs(); inputs.wheel_l_fresh = 0U;
    expect_freshness_fault_after_debounce(inputs, FAULT_WHEEL_LEFT);
    inputs = healthy_inputs(); inputs.wheel_r_fresh = 0U;
    expect_freshness_fault_after_debounce(inputs, FAULT_WHEEL_RIGHT);
    inputs = healthy_inputs(); inputs.servos_fresh = 0U;
    expect_freshness_fault_after_debounce(inputs, FAULT_SERVO);

    safety_state_init();
    inputs = healthy_inputs();
    inputs.requested_mode = STATE_FAULT;
    (void)safety_state_update(&inputs);
    TEST_TRUE((g_safety_state.fault_mask & FAULT_EMERGENCY) != 0U);

    safety_state_init();
    g_safety_state.current_mode = (RobotMode_t)99;
    inputs = healthy_inputs();
    (void)safety_state_update(&inputs);
    TEST_TRUE((g_safety_state.fault_mask & FAULT_INTERNAL) != 0U);

    safety_state_init();
    for (int i = 0; i < 1000; ++i) {
        safety_state_gyro_calib_update(0.01f, -0.02f, 0.03f, (uint32_t)i);
    }
    TEST_TRUE(g_safety_state.is_gyro_calibrated);
    TEST_NEAR(0.01f, g_safety_state.gyro_calib_offset[0], 1.0e-5f);
    TEST_NEAR(-0.02f, g_safety_state.gyro_calib_offset[1], 1.0e-5f);
    TEST_NEAR(0.03f, g_safety_state.gyro_calib_offset[2], 1.0e-5f);
    TEST_EQ_INT(STATE_INIT, g_safety_state.current_mode);

    /* Moving samples are skipped, not reset: scattered still samples still
     * accumulate (bounded by the sample-gap guard). */
    safety_state_init();
    for (int i = 0; i < 500; ++i) {
        safety_state_gyro_calib_update(0.01f, 0.01f, 0.01f, (uint32_t)i);
    }
    for (int i = 0; i < 500; ++i) {
        safety_state_gyro_calib_update(0.5f, 0.0f, 0.0f, (uint32_t)(500 + i));
    }
    for (int i = 0; i < 499; ++i) {
        safety_state_gyro_calib_update(0.01f, 0.01f, 0.01f, (uint32_t)(1000 + i));
    }
    TEST_TRUE(!g_safety_state.is_gyro_calibrated);   /* 999 still < 1000 */
    safety_state_gyro_calib_update(0.01f, 0.01f, 0.01f, 1499U);
    TEST_TRUE(g_safety_state.is_gyro_calibrated);     /* 1000th still sample */
    TEST_NEAR(0.01f, g_safety_state.gyro_calib_offset[0], 1.0e-5f);

    /* A >50 ms sample gap restarts the window: stale and fresh samples must
     * not average together across a real interruption. */
    safety_state_init();
    for (int i = 0; i < 600; ++i) {
        safety_state_gyro_calib_update(0.01f, 0.01f, 0.01f, (uint32_t)i);
    }
    for (int i = 0; i < 600; ++i) {
        safety_state_gyro_calib_update(0.01f, 0.01f, 0.01f, (uint32_t)(1000 + i));
    }
    TEST_TRUE(!g_safety_state.is_gyro_calibrated);   /* gap reset: only 600 */

    /* A constantly moving robot never completes calibration. */
    safety_state_init();
    for (int i = 0; i < 2000; ++i) {
        safety_state_gyro_calib_update(0.1f, -0.2f, 0.3f, (uint32_t)i);
    }
    TEST_TRUE(!g_safety_state.is_gyro_calibrated);

    /* --- Grace window on mode transition --- */
    safety_state_init();
    inputs = healthy_inputs();
    (void)safety_state_update(&inputs);           /* INIT -> STAND */
    TEST_EQ_INT(STATE_STAND, g_safety_state.current_mode);
    TEST_TRUE(g_safety_state.mode_grace_until_ms > 0U);

    /* Within grace window, a single stale IMU tick does not latch. */
    inputs.now_ms = 101U;
    inputs.imu_fresh = 0U;
    (void)safety_state_update(&inputs);
    TEST_EQ_INT(STATE_STAND, g_safety_state.current_mode);
    TEST_TRUE((g_safety_state.fault_mask & FAULT_IMU) == 0U);

    /* After grace expires, debounce still applies. */
    inputs.now_ms = g_safety_state.mode_grace_until_ms + 1U;
    for (uint8_t i = 0; i < SAFETY_FRESHNESS_DEBOUNCE_TICKS; ++i) {
        (void)safety_state_update(&inputs);
    }
    TEST_EQ_INT(STATE_FAULT, g_safety_state.current_mode);
    TEST_TRUE((g_safety_state.fault_mask & FAULT_IMU) != 0U);

    /* A serious fault arriving during transient recovery is combined and
     * remains latched; it must not be erased by the transient clear path. */
    safety_state_init();
    inputs = healthy_inputs();
    enter_stand(&inputs);
    inputs.now_ms = g_safety_state.mode_grace_until_ms + 1U;
    inputs.wheel_l_fresh = 0U;   /* transient device fault, debounced */
    for (uint8_t i = 0U; i < SAFETY_FRESHNESS_DEBOUNCE_TICKS; ++i) {
        (void)safety_state_update(&inputs);
        inputs.now_ms += 4U;
    }
    TEST_EQ_INT(STATE_FAULT, g_safety_state.current_mode);
    TEST_TRUE((g_safety_state.fault_mask & FAULT_WHEEL_LEFT) != 0U);
    /* The transient recovers in the SAME update that reports a new serious
     * tilt fault: the new fault must be merged, never dropped by the recovery
     * branch (the original bug returned STAND here for one cycle). */
    inputs.wheel_l_fresh = 1U;
    inputs.pitch_rad = SAFETY_MAX_PITCH_RAD + 0.2f;
    (void)safety_state_update(&inputs);
    TEST_TRUE((g_safety_state.fault_mask & FAULT_TILT) != 0U);
    TEST_EQ_INT(STATE_FAULT, g_safety_state.current_mode);
    /* Serious faults stay latched after the condition disappears. */
    inputs.pitch_rad = 0.0f;
    (void)safety_state_update(&inputs);
    TEST_EQ_INT(STATE_FAULT, g_safety_state.current_mode);
    TEST_TRUE((g_safety_state.fault_mask & FAULT_TILT) != 0U);

    /* Non-finite physical inputs are safety faults, never silently accepted. */
    inputs = healthy_inputs();
    inputs.pitch_rad = NAN;
    expect_immediate_fault(inputs, FAULT_TILT);
    inputs = healthy_inputs();
    inputs.pitch_rate_rads = INFINITY;
    expect_immediate_fault(inputs, FAULT_PITCH_RATE);
    inputs = healthy_inputs();
    inputs.max_temp_c = NAN;
    expect_immediate_fault(inputs, FAULT_OVERTEMP);

    /* Hard faults still latch even during the grace window. */
    safety_state_init();
    inputs = healthy_inputs();
    (void)safety_state_update(&inputs);           /* INIT -> STAND, grace active */
    inputs.now_ms = 101U;
    inputs.pitch_rad = SAFETY_MAX_PITCH_RAD + 0.1f;
    (void)safety_state_update(&inputs);
    TEST_EQ_INT(STATE_FAULT, g_safety_state.current_mode);
    TEST_TRUE((g_safety_state.fault_mask & FAULT_TILT) != 0U);

    /* A Pi flapping mode requests must not suppress freshness faults: only
     * the device-driven transitions (INIT->STAND, FAULT->STAND) reset the
     * stale counters and re-open the grace window.  Command-driven
     * transitions (STAND<->ACTIVE, link-loss demotion) change no device
     * state, so before this rule a >10 Hz mode flap kept the grace window
     * permanently open and wheel/servo loss faults never latched. */
    safety_state_init();
    inputs = healthy_inputs();
    enter_stand(&inputs);                          /* INIT->STAND: grace granted */
    inputs.now_ms = g_safety_state.mode_grace_until_ms + 1U; /* grace expired */
    inputs.wheel_l_fresh = 0U;
    for (uint8_t i = 0U; i < SAFETY_FRESHNESS_DEBOUNCE_TICKS - 1U; ++i) {
        inputs.now_ms += 4U;
        inputs.requested_mode = (i & 1U) ? (uint8_t)STATE_ACTIVE
                                         : (uint8_t)STATE_STAND;
        (void)safety_state_update(&inputs);
    }
    inputs.now_ms += 4U;
    inputs.requested_mode = (uint8_t)STATE_STAND;
    (void)safety_state_update(&inputs);
    TEST_EQ_INT(STATE_FAULT, g_safety_state.current_mode);
    TEST_TRUE((g_safety_state.fault_mask & FAULT_WHEEL_LEFT) != 0U);

    /* A request to leave the motion modes is honoured even when it names
     * INIT: INIT is a boot state with no inbound transition, so the only
     * consistent reading of "stop" from a walking robot is STAND.  Before
     * this rule an INIT request was silently ignored and the robot kept
     * driving while the sender believed it had been obeyed. */
    safety_state_init();
    inputs = healthy_inputs();
    enter_stand(&inputs);
    inputs.requested_mode = STATE_ACTIVE;
    (void)safety_state_update(&inputs);
    TEST_EQ_INT(STATE_ACTIVE, g_safety_state.current_mode);
    inputs.requested_mode = STATE_INIT;
    (void)safety_state_update(&inputs);
    TEST_EQ_INT(STATE_STAND, g_safety_state.current_mode);
    /* STAND ignores both INIT (no inbound transition) and CLIMB (reachable
     * only through the ACTIVE arming step): the robot keeps holding. */
    inputs.requested_mode = STATE_INIT;
    (void)safety_state_update(&inputs);
    TEST_EQ_INT(STATE_STAND, g_safety_state.current_mode);
    inputs.requested_mode = STATE_CLIMB;
    (void)safety_state_update(&inputs);
    TEST_EQ_INT(STATE_STAND, g_safety_state.current_mode);
    /* The same demotion applies from CLIMB. */
    inputs.requested_mode = STATE_ACTIVE;
    (void)safety_state_update(&inputs);
    TEST_EQ_INT(STATE_ACTIVE, g_safety_state.current_mode);
    inputs.requested_mode = STATE_CLIMB;
    (void)safety_state_update(&inputs);
    TEST_EQ_INT(STATE_CLIMB, g_safety_state.current_mode);
    inputs.requested_mode = STATE_INIT;
    (void)safety_state_update(&inputs);
    TEST_EQ_INT(STATE_STAND, g_safety_state.current_mode);
    /* An ACTIVE request from CLIMB is still honoured, and CLIMB remains
     * reachable only through the ACTIVE arming step. */
    inputs.requested_mode = STATE_ACTIVE;
    (void)safety_state_update(&inputs);
    TEST_EQ_INT(STATE_ACTIVE, g_safety_state.current_mode);
    inputs.requested_mode = STATE_CLIMB;
    (void)safety_state_update(&inputs);
    TEST_EQ_INT(STATE_CLIMB, g_safety_state.current_mode);
    inputs.requested_mode = STATE_ACTIVE;
    (void)safety_state_update(&inputs);
    TEST_EQ_INT(STATE_ACTIVE, g_safety_state.current_mode);
}
