Weilv-D/kuafu/stm32_firmware/tests/test_pi_link.c

#include "pi_link.h"
#include "pi_transport.h"
#include "crc8.h"
#include "kuafu_generated.h"
#include "test_support.h"

#include <math.h>
#include <string.h>

static uint16_t build_frame(uint8_t *frame, uint8_t version, uint8_t type,
                            uint16_t sequence, const uint8_t *payload,
                            uint8_t payload_len) {
    uint16_t total = (uint16_t)(12U + payload_len);
    frame[0] = PI_FRAME_HEADER; frame[1] = version; frame[2] = type;
    frame[3] = payload_len; frame[4] = (uint8_t)(sequence >> 8);
    frame[5] = (uint8_t)sequence;
    frame[6] = 0U; frame[7] = 0U; frame[8] = 0U; frame[9] = 1U;
    if (payload_len > 0U) memcpy(&frame[10], payload, payload_len);
    frame[10U + payload_len] = crc8_calculate(&frame[1], (uint16_t)(9U + payload_len));
    frame[11U + payload_len] = PI_FRAME_FOOTER;
    return total;
}

static void put_i16(uint8_t *bytes, int16_t value) {
    bytes[0] = (uint8_t)((uint16_t)value >> 8);
    bytes[1] = (uint8_t)value;
}

static void make_heartbeat(uint8_t payload[7], uint8_t mode,
                           int16_t velocity, int16_t yaw, int16_t d0_mm) {
    payload[0] = mode;
    put_i16(&payload[1], velocity);
    put_i16(&payload[3], yaw);
    put_i16(&payload[5], d0_mm);
}

void run_pi_link_tests(void) {
    uint8_t frame[96];
    uint8_t second[96];
    uint8_t joined[192];
    uint8_t heartbeat[7];
    uint8_t action[12];
    uint8_t bad_hash[16];
    uint16_t len;
    uint16_t len2;
    int i;
    UART_HandleTypeDef uart;
    Pi_HealthTelemetry_t health;
    uint8_t health_payload[PI_HEALTH_PAYLOAD_SIZE];

    test_set_time_ms(100U);
    pi_link_init();
    memset(bad_hash, '0', sizeof(bad_hash));
    len = build_frame(frame, PI_PROTOCOL_VERSION, PI_CMD_HELLO, 1U,
                      bad_hash, 16U);
    TEST_EQ_INT(0, pi_link_parse_packet(frame, len));
    TEST_TRUE(!pi_link_is_compatible());

    len = build_frame(frame, 2U, PI_CMD_HELLO, 2U,
                      (const uint8_t *)KUAFU_MODEL_HASH, 16U);
    len2 = build_frame(second, PI_PROTOCOL_VERSION, PI_CMD_HELLO, 10U,
                       (const uint8_t *)KUAFU_MODEL_HASH, 16U);
    memcpy(joined, frame, len); memcpy(&joined[len], second, len2);
    TEST_EQ_INT(1, pi_link_parse_packet(joined, (uint16_t)(len + len2)));
    TEST_TRUE(pi_link_is_compatible());

    make_heartbeat(heartbeat, 1U, 100, -200, 58);
    len = build_frame(frame, PI_PROTOCOL_VERSION, PI_CMD_HEARTBEAT, 11U,
                      heartbeat, sizeof(heartbeat));
    TEST_EQ_INT(0, pi_link_parse_packet(frame, 5U));
    TEST_EQ_INT(1, pi_link_parse_packet(&frame[5], (uint16_t)(len - 5U)));
    TEST_NEAR(0.1f, g_pi_cmd_heartbeat.target_velocity, 0.0001f);
    TEST_NEAR(-0.2f, g_pi_cmd_heartbeat.target_yaw_rate, 0.0001f);
    TEST_TRUE(pi_link_heartbeat_fresh());
    TEST_EQ_INT(0, pi_link_parse_packet(frame, len));

    frame[len - 2U] ^= 1U;
    TEST_EQ_INT(0, pi_link_parse_packet(frame, len));

    make_heartbeat(heartbeat, 1U, 600, 0, 58);
    len = build_frame(frame, PI_PROTOCOL_VERSION, PI_CMD_HEARTBEAT, 12U,
                      heartbeat, sizeof(heartbeat));
    TEST_EQ_INT(0, pi_link_parse_packet(frame, len));

    for (i = 0; i < 6; ++i) put_i16(&action[2 * i], (int16_t)(i & 1 ? -10000 : 10000));
    len = build_frame(frame, PI_PROTOCOL_VERSION, PI_CMD_ACTION, 12U,
                      action, sizeof(action));
    TEST_EQ_INT(1, pi_link_parse_packet(frame, len));
    TEST_NEAR(1.0f, g_pi_cmd_action.delta_torque_common, 0.0001f);
    TEST_NEAR(-1.0f, g_pi_cmd_action.delta_torque_yaw, 0.0001f);

    put_i16(action, 10001);
    len = build_frame(frame, PI_PROTOCOL_VERSION, PI_CMD_ACTION, 13U,
                      action, sizeof(action));
    TEST_EQ_INT(0, pi_link_parse_packet(frame, len));
    put_i16(action, 5000);
    test_set_time_ms(350U);
    len = build_frame(frame, PI_PROTOCOL_VERSION, PI_CMD_ACTION, 13U,
                      action, sizeof(action));
    TEST_EQ_INT(1, pi_link_parse_packet(frame, len));
    test_set_time_ms(400U);
    TEST_TRUE(!pi_link_heartbeat_fresh());
    TEST_TRUE(pi_link_action_fresh());
    pi_link_clear_action();
    TEST_TRUE(!pi_link_action_fresh());
    pi_link_enter_hold();
    TEST_NEAR(0.0f, g_pi_cmd_heartbeat.target_velocity, 0.0001f);

    /* A new HELLO resets the sequence window; 65535 -> 0 is a valid wrap. */
    test_set_time_ms(500U);
    len = build_frame(frame, PI_PROTOCOL_VERSION, PI_CMD_HELLO, 65534U,
                      (const uint8_t *)KUAFU_MODEL_HASH, 16U);
    TEST_EQ_INT(1, pi_link_parse_packet(frame, len));
    make_heartbeat(heartbeat, 1U, 0, 0, 58);
    len = build_frame(frame, PI_PROTOCOL_VERSION, PI_CMD_HEARTBEAT, 65535U,
                      heartbeat, sizeof(heartbeat));
    len2 = build_frame(second, PI_PROTOCOL_VERSION, PI_CMD_ACTION, 0U,
                       action, sizeof(action));
    joined[0] = 0x22U; joined[1] = 0xA4U;
    memcpy(&joined[2], frame, len); memcpy(&joined[2U + len], second, len2);
    TEST_EQ_INT(2, pi_link_parse_packet(joined, (uint16_t)(2U + len + len2)));
    TEST_EQ_INT(0, pi_link_parse_packet(frame, len));

    /* Peer-restart resync (firmware mirror of the Pi decoder's RESYNC_REJECTS):
     * a Pi that reboots with its single startup HELLO corrupted on the wire
     * restarts its sequence at 0 while the stored high-water mark stays.  The
     * first PI_RX_RESYNC_REJECTS gated rejections are dropped as before, then
     * the gate concludes the peer restarted and accepts the stream again —
     * without it the lockout lasts until the counter climbs back to the old
     * mark (minutes at 50 Hz). */
    {
        uint16_t reboot_seq;
        pi_link_init();
        test_set_time_ms(600U);
        make_heartbeat(heartbeat, 1U, 100, 0, 58);
        len = build_frame(frame, PI_PROTOCOL_VERSION, PI_CMD_HEARTBEAT, 30000U,
                          heartbeat, sizeof(heartbeat));
        TEST_EQ_INT(1, pi_link_parse_packet(frame, len));
        for (reboot_seq = 0U; reboot_seq < 8U; ++reboot_seq) {
            len = build_frame(frame, PI_PROTOCOL_VERSION, PI_CMD_HEARTBEAT,
                              reboot_seq, heartbeat, sizeof(heartbeat));
            TEST_EQ_INT(0, pi_link_parse_packet(frame, len));
        }
        len = build_frame(frame, PI_PROTOCOL_VERSION, PI_CMD_HEARTBEAT, 8U,
                          heartbeat, sizeof(heartbeat));
        TEST_EQ_INT(1, pi_link_parse_packet(frame, len));
        TEST_NEAR(0.1f, g_pi_cmd_heartbeat.target_velocity, 0.0001f);
        /* An isolated duplicate is still dropped: the resync counter resets on
         * every accepted frame, so one replay cannot reopen the gate. */
        TEST_EQ_INT(0, pi_link_parse_packet(frame, len));
    }

    test_uart_reset();
    pi_link_init();
    TEST_EQ_INT(0, pi_link_send_diag(&uart, 0U, 40U, 0U));
    TEST_EQ_INT(0, pi_link_send_fault(&uart, 3U));
    TEST_EQ_INT(1, (int)test_uart_tx_count());
    pi_link_on_tx_complete(&uart);
    TEST_EQ_INT(2, (int)test_uart_tx_count());
    pi_link_on_tx_complete(&uart);

    memset(&health, 0, sizeof(health));
    health.fault_mask = 0x12345678UL;
    health.mode = 3U;
    health.reset_cause = 0x21U;
    health.imu_age_ms = 0x0102U;
    health.wheel_l_age_ms = 0x0304U;
    health.wheel_r_age_ms = 0x0506U;
    health.servo_age_ms[3] = 0x0708U;
    health.imu_errors = 0x090AU;
    health.servo_errors[3] = 0x0B0CU;
    health.wheel_l_timeout_errors = 0x0D0EU;
    health.wheel_r_checksum_errors = 0x0F10U;
    pi_link_encode_health_payload(health_payload, &health);
    TEST_EQ_U8(0x12U, health_payload[0]);
    TEST_EQ_U8(0x78U, health_payload[3]);
    TEST_EQ_U8(3U, health_payload[4]);
    TEST_EQ_U8(0x21U, health_payload[5]);
    TEST_EQ_U8(0x01U, health_payload[6]);
    TEST_EQ_U8(0x02U, health_payload[7]);
    TEST_EQ_U8(0x07U, health_payload[18]);
    TEST_EQ_U8(0x08U, health_payload[19]);
    TEST_EQ_U8(0x09U, health_payload[20]);
    TEST_EQ_U8(0x0AU, health_payload[21]);
    TEST_EQ_U8(0x0BU, health_payload[32]);
    TEST_EQ_U8(0x0CU, health_payload[33]);
    /* DDSM error breakdown appended after the legacy 34-byte block.
     * Layout (offset from 34): L_timeout[34..35] L_checksum[36..37]
     * L_protocol[38..39] R_timeout[40..41] R_checksum[42..43] R_protocol[44..45]. */
    TEST_EQ_U8(0x0DU, health_payload[34]);
    TEST_EQ_U8(0x0EU, health_payload[35]);
    TEST_EQ_U8(0x0FU, health_payload[42]);
    TEST_EQ_U8(0x10U, health_payload[43]);

    /* Non-finite telemetry values quantize to the protocol's zero sentinel
     * instead of reaching an undefined float-to-int cast.  The IMU payload is
     * roll..gz (six big-endian i16/1000) starting at frame offset 10: the
     * NaN roll encodes 0x0000 while the adjacent finite pitch is untouched. */
    test_uart_reset();
    TEST_EQ_INT(0, pi_link_send_imu(&uart, NAN, 1.0f, 2.0f,
                                    3.0f, 4.0f, 5.0f));
    {
        const uint8_t *tx = test_uart_last_tx();
        TEST_TRUE(tx != NULL);
        TEST_EQ_U8(0U, tx[10]);
        TEST_EQ_U8(0U, tx[11]);
        TEST_EQ_U8(0x03U, tx[12]);  /* 1.0 rad * 1000 = 0x03E8 */
        TEST_EQ_U8(0xE8U, tx[13]);
    }
}

void run_pi_transport_tests(void) {
    uint8_t ring[64] = {0};
    uint8_t frame[96];
    uint8_t heartbeat[7];
    PiTransport_t transport;
    uint16_t len;

    pi_link_init();
    len = build_frame(frame, PI_PROTOCOL_VERSION, PI_CMD_HELLO, 200U,
                      (const uint8_t *)KUAFU_MODEL_HASH, 16U);
    pi_transport_init(&transport, ring, sizeof(ring));
    memcpy(ring, frame, 20U);
    TEST_EQ_INT(0, pi_transport_poll(&transport, 0U, (uint16_t)(sizeof(ring) - 20U)));
    memcpy(&ring[20], &frame[20], (size_t)(len - 20U));
    TEST_EQ_INT(1, pi_transport_poll(&transport, 0U,
                                     (uint16_t)(sizeof(ring) - len)));
    TEST_TRUE(pi_link_is_compatible());

    /* Place a complete heartbeat across the physical end of the DMA ring.
     * The consumer has drained to absolute 60; the producer then completed
     * one more lap and sits at position 15, so the 19-byte frame straddles
     * the physical end (read_index == consumed % size invariant). */
    make_heartbeat(heartbeat, 1U, 50, 0, 58);
    len = build_frame(frame, PI_PROTOCOL_VERSION, PI_CMD_HEARTBEAT, 201U,
                      heartbeat, sizeof(heartbeat));
    transport.consumed_count = 60U;
    transport.read_index = 60U;
    transport.producer_count = 60U;
    memcpy(&ring[60], frame, 4U);
    memcpy(ring, &frame[4], (size_t)(len - 4U));
    TEST_EQ_INT(1, pi_transport_poll(&transport, 1U,
                                     (uint16_t)(sizeof(ring) - (len - 4U))));
    TEST_EQ_INT((int)(sizeof(ring) + (len - 4U)), (int)transport.consumed_count);
    TEST_EQ_INT((int)(len - 4U), (int)transport.read_index);
    TEST_NEAR(0.05f, g_pi_cmd_heartbeat.target_velocity, 0.0001f);

    /* A single chunk larger than the decoder's internal holding buffer must
     * be decoded, not dropped: after a main-loop stall the transport can
     * hand over a whole ring of bytes at once.  Ten heartbeats exceed the
     * buffer, so the sliced append path is exercised end to end. */
    {
        uint8_t burst[10 * 32];
        uint16_t burst_len = 0U;
        int burst_parsed;
        int j;
        for (j = 0; j < 10; ++j) {
            make_heartbeat(heartbeat, 1U, (int16_t)(10 * (j + 1)), 0, 58);
            burst_len = (uint16_t)(burst_len + build_frame(&burst[burst_len],
                                    PI_PROTOCOL_VERSION, PI_CMD_HEARTBEAT,
                                    (uint16_t)(400U + j), heartbeat,
                                    sizeof(heartbeat)));
        }
        burst_parsed = pi_link_parse_packet(burst, burst_len);
        TEST_EQ_INT(10, burst_parsed);
        TEST_NEAR(0.1f, g_pi_cmd_heartbeat.target_velocity, 0.0001f);
        TEST_TRUE(pi_link_heartbeat_fresh());
    }
}
