Weilv-D/kuafu/stm32_firmware/tests/test_st3215.c

#include "st3215.h"
#include "test_support.h"

#include <string.h>

static uint8_t st_checksum(const uint8_t *body, uint8_t size) {
    uint8_t sum = 0U;
    uint8_t i;
    for (i = 0U; i < size; ++i) sum = (uint8_t)(sum + body[i]);
    return (uint8_t)~sum;
}

static void make_state_frame(uint8_t frame[ST_STATE_FRAME_SIZE], uint8_t id) {
    memset(frame, 0, ST_STATE_FRAME_SIZE);
    frame[0] = 0xFFU; frame[1] = 0xFFU; frame[2] = id; frame[3] = 17U;
    frame[5] = 0x34U; frame[6] = 0x02U;
    frame[7] = 0x9CU; frame[8] = 0xFFU;
    frame[9] = 0x2CU; frame[10] = 0x05U;
    frame[11] = 120U; frame[12] = 45U;
    frame[18] = 0xF6U; frame[19] = 0xFFU;
    frame[20] = st_checksum(&frame[2], 18U);
}

static void feed(ST3215_Bus_t *bus, const uint8_t *bytes,
                 uint8_t count, uint32_t now_ms) {
    uint8_t i;
    for (i = 0U; i < count; ++i) {
        /* Production feeds bytes from the DMA ring in main-loop context. */
        st3215_bus_rx_byte_from_dma(bus, bytes[i], now_ms);
    }
}

void run_st3215_tests(void) {
    uint8_t packet[ST_MAX_PACKET_SIZE];
    uint8_t frame[ST_STATE_FRAME_SIZE];
    uint8_t ids[2] = {1U, 2U};
    int16_t positions[2] = {-1, 5000};
    uint16_t speeds[2] = {0x1234U, 0x5678U};
    uint8_t accels[2] = {10U, 20U};
    ST3215_State_t state;
    ST3215_Bus_t bus;
    UART_HandleTypeDef uart;
    int len;

    len = st3215_build_sync_write(packet, sizeof(packet), ids, 2U,
                                   positions, speeds, accels);
    TEST_EQ_INT(24, len);
    TEST_EQ_U8(0xFEU, packet[2]);
    TEST_EQ_U8(ST_INST_SYNC_WRITE, packet[4]);
    TEST_EQ_U8(0U, packet[9]); TEST_EQ_U8(0U, packet[10]);
    TEST_EQ_U8(0xFFU, packet[17]); TEST_EQ_U8(0x0FU, packet[18]);
    TEST_EQ_U8(st_checksum(&packet[2], 21U), packet[23]);

    TEST_EQ_INT(8, st3215_build_torque(packet, 3U, 1U));
    TEST_EQ_U8(3U, packet[2]); TEST_EQ_U8(ST_INST_WRITE, packet[4]);
    TEST_EQ_U8(ST_REG_TORQUE_ENABLE, packet[5]); TEST_EQ_U8(1U, packet[6]);
    TEST_EQ_U8(st_checksum(&packet[2], 5U), packet[7]);

    TEST_EQ_INT(8, st3215_build_torque(packet, ST3215_BROADCAST_ID, 0U));
    TEST_EQ_U8(ST3215_BROADCAST_ID, packet[2]);
    TEST_EQ_U8(0U, packet[6]);
    TEST_EQ_U8(st_checksum(&packet[2], 5U), packet[7]);

    memset(&state, 0, sizeof(state));
    state.id = 1U;
    device_health_init(&state.health);
    make_state_frame(frame, 1U);
    TEST_EQ_INT(0, st3215_parse_state_frame(frame, ST_STATE_FRAME_SIZE, &state));
    TEST_EQ_INT(0x234, state.position_tick);
    TEST_TRUE(state.velocity_rads < 0.0f);
    /* Speed is sign-magnitude: flipping ONLY bit15 must yield the same
     * magnitude with the opposite sign (a two's-complement decoder would
     * return a ~32768x larger negative value for 0x8064). */
    {
        float v_pos;
        float v_neg;
        make_state_frame(frame, 1U);
        frame[7] = 0x64U; frame[8] = 0x00U;              /* +100 ticks */
        frame[20] = st_checksum(&frame[2], 18U);
        TEST_EQ_INT(0, st3215_parse_state_frame(frame, ST_STATE_FRAME_SIZE, &state));
        v_pos = state.velocity_rads;
        TEST_TRUE(v_pos > 0.0f);
        frame[8] = 0x80U;                                 /* -100 ticks */
        frame[20] = st_checksum(&frame[2], 18U);
        TEST_EQ_INT(0, st3215_parse_state_frame(frame, ST_STATE_FRAME_SIZE, &state));
        v_neg = state.velocity_rads;
        TEST_TRUE(v_neg < 0.0f);
        TEST_NEAR(v_pos, -v_neg, 1.0e-6f);
    }
    TEST_NEAR(-0.300f, state.load, 0.001f);
    TEST_NEAR(12.0f, state.voltage, 0.001f);
    TEST_NEAR(45.0f, state.temperature_c, 0.001f);
    TEST_TRUE(state.current_a < 0.0f);
    make_state_frame(frame, 2U);
    TEST_EQ_INT(-2, st3215_parse_state_frame(frame, ST_STATE_FRAME_SIZE, &state));
    make_state_frame(frame, 1U); frame[20] ^= 1U;
    TEST_EQ_INT(-3, st3215_parse_state_frame(frame, ST_STATE_FRAME_SIZE, &state));

    test_uart_reset();
    st3215_bus_init(&bus, &uart);
    TEST_EQ_INT(0, st3215_bus_queue_read(&bus, &state, 3U, 100U));
    TEST_EQ_INT(ST_BUS_TX_READ, bus.phase);
    st3215_bus_on_tx_complete(&bus);
    TEST_EQ_INT(ST_BUS_WAIT_REPLY, bus.phase);

    /* Known request echo is discarded. Noise and partial response are retained. */
    feed(&bus, bus.tx, bus.tx_len, 101U);
    { const uint8_t noise[] = {0x12U, 0xFFU, 0x44U}; feed(&bus, noise, 3U, 101U); }
    make_state_frame(frame, 1U);
    feed(&bus, frame, 7U, 101U);
    TEST_EQ_INT(ST_BUS_WAIT_REPLY, bus.phase);
    feed(&bus, &frame[7], (uint8_t)(ST_STATE_FRAME_SIZE - 7U), 102U);
    TEST_TRUE(st3215_bus_is_idle(&bus));
    TEST_TRUE(state.health.online);
    TEST_EQ_INT(102, (int)state.health.last_valid_ms);

    /* A complete stale frame for another ID is ignored; adjacent target frame wins. */
    TEST_EQ_INT(0, st3215_bus_queue_read(&bus, &state, 3U, 110U));
    st3215_bus_on_tx_complete(&bus);
    make_state_frame(frame, 2U);
    feed(&bus, frame, ST_STATE_FRAME_SIZE, 111U);
    TEST_EQ_INT(ST_BUS_WAIT_REPLY, bus.phase);
    make_state_frame(frame, 1U);
    feed(&bus, frame, ST_STATE_FRAME_SIZE, 112U);
    TEST_TRUE(st3215_bus_is_idle(&bus));

    TEST_EQ_INT(0, st3215_bus_queue_read(&bus, &state, 3U, 120U));
    st3215_bus_step(&bus, 122U);
    TEST_EQ_INT(ST_BUS_TX_READ, bus.phase);
    st3215_bus_step(&bus, 129U);
    TEST_EQ_INT(ST_BUS_TX_READ, bus.phase);  /* 10 ms reply budget not yet spent */
    st3215_bus_step(&bus, 131U);            /* 11 ms elapsed -> timeout latched */
    TEST_TRUE(st3215_bus_is_idle(&bus));
    TEST_EQ_INT(1, (int)state.health.timeout_count);

    /* UART errors are recorded by the ISR (on_uart_error) and applied by the
     * main-loop step only: the callback itself must not mutate transaction,
     * parser, or health state from interrupt context. */
    TEST_EQ_INT(0, st3215_bus_queue_read(&bus, &state, 3U, 200U));
    st3215_bus_on_tx_complete(&bus);
    TEST_EQ_INT(ST_BUS_WAIT_REPLY, bus.phase);
    st3215_bus_on_uart_error(&bus);
    TEST_EQ_INT(ST_BUS_WAIT_REPLY, bus.phase);  /* deferred: nothing applied yet */
    TEST_EQ_INT(0, (int)state.health.protocol_count);
    st3215_bus_step(&bus, 201U);                /* applied in main-loop context */
    TEST_TRUE(st3215_bus_is_idle(&bus));
    TEST_EQ_INT(1, (int)state.health.protocol_count);

    /* A lost TX-complete interrupt must not wedge the bus: write frames
     * carry their own deadline and recover through an explicit transmit
     * abort, after which the bus accepts new work immediately. */
    test_set_time_ms(300U);
    TEST_EQ_INT(0, st3215_bus_queue_torque(&bus, 1U, 1U));
    TEST_EQ_INT(ST_BUS_TX_ONLY, bus.phase);
    st3215_bus_step(&bus, 305U);
    TEST_EQ_INT(ST_BUS_TX_ONLY, bus.phase);     /* inside the write budget */
    st3215_bus_step(&bus, 321U);                /* deadline passed: recover */
    TEST_TRUE(st3215_bus_is_idle(&bus));
    TEST_EQ_INT(0, st3215_bus_queue_torque(&bus, 1U, 1U));
    TEST_EQ_INT(ST_BUS_TX_ONLY, bus.phase);
    st3215_bus_on_tx_complete(&bus);            /* normal close still works */
    TEST_TRUE(st3215_bus_is_idle(&bus));

    /* A UART error during a write frame must run the SAME HAL-transmit
     * recovery as the lost-TX-complete deadline above: going IDLE without
     * the explicit AbortTransmit strands gState at BUSY_TX whenever the
     * error and the lost completion coincide, and every later queue call
     * then fails HAL_BUSY forever (no leg writes -> wheel gate closes). */
    test_uart_reset();
    test_set_time_ms(400U);
    TEST_EQ_INT(0, st3215_bus_queue_torque(&bus, 1U, 1U));
    TEST_EQ_INT(ST_BUS_TX_ONLY, bus.phase);
    st3215_bus_on_uart_error(&bus);
    TEST_EQ_INT(ST_BUS_TX_ONLY, bus.phase);  /* deferred: nothing applied yet */
    st3215_bus_step(&bus, 401U);             /* applied well inside the budget */
    TEST_TRUE(st3215_bus_is_idle(&bus));
    TEST_EQ_INT(1, (int)test_uart_abort_count()); /* HAL TX state cleared */
    TEST_EQ_INT(0, st3215_bus_queue_torque(&bus, 1U, 1U));
    st3215_bus_on_tx_complete(&bus);
    TEST_TRUE(st3215_bus_is_idle(&bus));
}
