Weilv-D/kuafu/(commit log)

2026-07-08 docs: add single-source hardware assembly guide
2026-07-08 docs: update and refine assembly and startup reference guides
2026-07-08 docs: update mechanical design status to completed and 3D printing in progress
2026-07-08 fix(rl): align CAD-measured mass distribution (chassis 0.609kg, link 0.035kg)
2026-07-08 fix(rl): correct wheel kinematics mount coordinates in closed-loop system
2026-07-08 fix(rl): correct actuator control ranges and prevent contact penetration
2026-07-08 fix(rl): systematically fix review findings and coordinate frame errors
2026-07-08 fix(rl): return reset observation at done frames and correct hip difference scale
2026-07-08 fix(rl): systematically fix coordinate frames, physics, and distillation pipeline
2026-07-08 fix(rl): update energy reward to use torque squared for hip copper loss proxy
2026-07-09 feat(rl): implement per-env curriculum learning, velocity kicks, and teleoperation framework
    - Scale DR ranges, cmd limits, and actuator perturbations by per-env difficulty
    - Add gamepad, keyboard, and autonomous teleoperation framework under rl/teleop/
    - Implement periodic horizontal push forces (velocity kicks) on chassis
    - Fix step 0 history sequence and DDSM back-EMF torque limit in playbacks
    - Add SLAM and autonomous navigation design selection document
2026-07-09 feat(stm32): add hardware pin connections doc
2026-07-09 docs(stm32): update USART1 silkscreen labels to TXD/RXD
2026-07-09 docs(stm32): update CH340 connection silkscreen labels to TXD/RXD
2026-07-09 feat(stm32): implement complete real-time cerebellum firmware codebase
2026-07-09 refactor(stm32): move IMU acquisition to main loop scheduler and merge pin connection doc to README.md
2026-07-09 docs(stm32): correct serial download instructions and add protocol reference sources
2026-07-09 docs(stm32): add board-level specification review details for LXB407ZG-P1
2026-07-09 docs(stm32): refine README.md tone to be formal, concise, and remove excessive parentheses
2026-07-09 chore(git): add Keil MDK-ARM ignore rules to .gitignore
2026-07-09 feat(stm32): import MDK-ARM Keil project from reference examples and auto-configure all custom files, groups, and include paths
2026-07-09 chore(stm32): clean up host scratch scripts and test files to keep repository neat
2026-07-09 chore(stm32): remove unused reference template user drivers and listings to keep codebase tidy
2026-07-09 refactor(stm32): clean up header includes to use direct filenames, optimizing build compatibility with Keil include paths
2026-07-09 refactor(stm32): reorganize codebase to place all custom application files inside Core/Src and Core/Inc, and remove duplicate root folders
2026-07-09 docs(stm32): update README.md directory structure section to match reorganized layout
2026-07-09 feat(stm32): rename Keil project file to stm32_firmware and update internal target/output names
2026-07-09 fix(stm32): enable I2C module in hal_conf, fix VOS scale macro in main, include math.h in math files, and remove deleted User group from Keil XML
    [lqr_controller.c, mahony.c, main.c, safety_state.c]
2026-07-09 fix(stm32): replace undefined I2C_MEMSIZE_8BIT with standard HAL I2C_MEMADD_SIZE_8BIT in bmi088.c
    [bmi088.c]
2026-07-09 fix(stm32): remove duplicate system_stm32f4xx.c reference from Drivers/CMSIS group in Keil XML to prevent duplicate symbol linker errors
2026-07-09 fix(stm32): add missing stm32f4xx_hal_i2c.c driver file to Keil project to resolve undefined I2C symbol linker errors
2026-07-09 feat(stm32): implement non-blocking automatic offline detection for missing/disconnected servos to prevent real-time control loop lag
    [main.c, st3215.c, st3215.h]
2026-07-10 fix(stm32): systematic control, safety and servo-interface overhaul
    - lqr: wire Pi velocity/yaw setpoints into the controller and compute
    the balancing torque once per 250 Hz cycle (single integration),
    caching left/right commands across slots 0/1
    - ddsm: discard RS485 half-duplex self-echo before reading feedback
    - bmi088: read die temperature so overtemp protection and telemetry
    report real values
    - servo: define firmware-authoritative interface (sim-frame angles,
    dwell=0, order [LF,RF,LB,RB]) with per-servo SERVO_DIR mirror and
    SERVO_CENTER zero; unify ACTIVE and STAND/CLIMB mapping
    - kinematics: return dwell-relative crank angles sign-matched to the
    sim/RL joint convention; u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
    [bmi088.c, bmi088.h, kinematics.c, kinematics.h, main.c, pin_config.h, safety_state.c, safety_state.h]
2026-07-10 fix(stm32): report joint feedback in the shared command frame
    Feedback telemetry was left in the raw actuator frame while commands use
    the sim/body frame, so mirrored servos reported sign-flipped positions and
    the per-servo mechanical zero was ignored.
    - servo feedback: apply the inverse SERVO_DIR/SERVO_CENTER mapping to
    reported position and velocity (symmetric with Servo_Angle_To_Ticks)
    - wheels: add calibratable WHEEL_DIR_L/R body-frame direction, applied to
    torque commands, LQR velocity feedback and telemetry (default no-op)
    - forward-declare Servo_Feedback_Angle; document the frame contract and
    wheel-direction calibration in the README
    [main.c, pin_config.h]
2026-07-10 feat(rl): harden DAgger distillation with replay buffer, DLPack guards and reproducibility
    - distill.py: upgrade online DAgger to aggregated replay-buffer DAgger
    (ring buffer + DataLoader), add gradient clipping, TensorBoard logging,
    periodic sample replay, --seed and device-fallback CLI; fix (history,action)
    pairing for reset envs so stored (s,a*) labels stay correct
    - dlpack_utils.py / seed_utils.py: contract-based zero-copy DLPack bridge
    (copy=False guard + startup verify + CPU fallback) and unified RNG seeding
    with version provenance
    - train.py / teacher_model.py: seed-all + provenance in run.json, DLPack guards,
    friendlier checkpoint load errors
    - train_config.py: DISTILL si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
2026-07-10 feat(rl): three-axis safety baseline, RMA actor-conditioning, terrain, reward restructure
    Control architecture (physics-calibrated, verify_model 13/13):
    - pitch: LQR baseline (K verified, 0.1s recover 5°)
    - yaw: conditional damping (|ωz|<0.3 only; coaxial-wheel IP yaw-spin
    couples pitch instability -- calibrated, command tracking delegated to RL)
    - roll: leg PD via left/right D0 differential (0.1s recover 3°)
    - RL residual on top of three-axis baseline; RL failure -> pitch+roll safe
    RMA (Kumar 2021) corrected: teacher actor conditioned on static latent z(9)
    during training (proprio 148 + z 9 = 157; critic 160). Student adapter
    predicts z_hat from 50-step history. DAgger distillation al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
2026-07-10 chore(rl): increase default training iterations to 12000 and harden DLPack device resolution
    - Bump ITERATIONS default from 3000 to 12000 for more thorough training
    - Resolve explicit cuda:N device index to ensure DLPack zero-copy consistency
    - Clean up docstrings in dlpack_utils.py
2026-07-10 fix(rl): prevent entropy collapse, fix reward conflicts, bidirectional curriculum
    Training diagnostics revealed entropy collapse (→-10), episode length
    locked at ~800 (4th push kill), and difficulty metric oscillation.
    Root causes and fixes:
    - entropy_coef 0.005→0.01: doubled exploration bonus to slow σ collapse
    - alive gating: alive=1-fallen_flag, prevents farming alive reward
    during soft-termination grace window (fall_penalty stays 1.0)
    - extension_cost: only penalize extension beyond d0_cmd target, not
    commanded extension (eliminates gradient conflict with d0_avg_tracking)
    - difficulty logging: moved out of done_any block, logged every step
    (fixes TensorBoard oscillation artif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
2026-07-11 fix(rl): correct DR bias, latency, teleop/export dims and arbiter smoothing
    env:
    - servo_pd DR: scale biasprm[1] (-kp) not biasprm[0] (const 0); leg equilibrium
    was biased to pd_scale*cmd
    - action latency DR off-by-one: delay=k now takes k steps before (was k+1),
    consistent with obs-delay path
    - wheel contact: mask contact.geom by data.ncon (stale slots caused false
    ground-contact positives)
    - roll leveling: drop spurious 2x factor (effective ROLL_KP was doubled)
    - kuafu_env OBS_DIM comment 140 -> 148
    verify/export:
    - teleop_sim: teacher inference fed 148-dim (missing z) -> crash; concat
    NOMINAL_STATIC to 157. pass command to _apply_action (d0 teleop + OOD fix)
    - export_policy: teac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
2026-07-11 fix(firmware): align LQR base layer with RL sim and fix protocol parsing bugs
    LQR controller alignment (lqr_controller.h/c, main.c, pin_config.h):
    - Remove position integrator, anti-windup, target_velocity, target_yaw_rate
    (RL sim holds x=0, no position loop in base layer)
    - Rewrite control law to match kuafu_mjx_env._lqr_balance line-by-line:
    F = -(K·[0,θ,ẋ,θ̇]), τ_pitch = F·R/2
    conditional yaw damping: τ_diff = clip(-0.05·ωz, ±0.55) when |ωz|<0.3
    residual overlay: τ_L = τ_pitch + τ_diff + Δτ_L×0.55
    - Call LQR once per 250Hz cycle (slot 0 only) instead of twice (slot 0+1)
    - Add WHEEL_RADIUS_M, TAU_WHEEL_RATED, YAW_KD, YAW_DAMP_THRESH constants
    ST3215 protocol fix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
    [bmi088.c, ddsm315.c, lqr_controller.c, lqr_controller.h, mahony.c, main.c, pi_link.c, pin_config.h]
2026-07-11 fix(rl): align eval/verify roll-PD base layer with training env
    eval_policy.py 与 verify_model.py 的 roll 调平基底层多了一个 *2 系数,
    与训练环境 kuafu_mjx_env.py 的 d_d0_rad 公式不一致, 导致评估/回放
    不能如实反映训练策略的控制律。改为 * P.HIP_STROKE 与训练对齐。
2026-07-11 chore(rl): align PPO hyperparams to RSL-RL defaults (entropy 0.01, value_loss 1.0)
    After fixing environment bugs (servo_pd biasprm, wheel-contact ncon masking,
    roll-leveling 2x, action-latency off-by-one) and LQR base-layer alignment,
    the dynamics are clean. Revert entropy_coef 0.03->0.01 and value_loss_coef
    0.05->1.0 to RSL-RL standard defaults: adaptive KL (desired_kl=0.01) already
    controls entropy, and 3072 parallel envs provide strong implicit regularization,
    so high exploration bonus is unnecessary and was causing over-randomized policies.
2026-07-11 perf(rl): raise NUM_ENVS to 3072, donate env buffers, enable CUDA graphs + compile cache
    - train_config: NUM_ENVS 1024 -> 3072 (RTX 4070 8GB 实测可行)
    - train/distill: donate_argnums on reset/step (state buffer reuse)
    - train/distill: JAX_COMPILATION_CACHE_DIR + --xla_gpu_enable_cuda_graphs
    to cut per-step launch overhead on the fixed-shape rollout.
    All changes are runtime-only; no change to physics, solver, substeps or precision.
2026-07-12 perf(rl): increase NUM_ENVS to 4096 for improved training capacity
2026-07-12 fix(rl): correct JaxRollout scan normalization ordering
    The scan body skipped norm_forward at t==0, feeding raw (un-normalized)
    obs to the actor while the policy was trained on normalized obs, so every
    rollout's first step produced a wrong action and episodes collapsed at the
    72-step boundary. norm_update also froze the jax normalizer because until=1e8
    was below the checkpoint's sample count (~1.9e8), diverging obs_norm from
    torch. Reorder to update-then-normalize to match torch's semantics.
2026-07-12 refactor(rl): remove one-shot JaxRollout scan collection
    The scan training mode was slower and used more memory than step-by-step
    collection on RTX 4070 8GB (jax MLP ~4.6x slower than torch's cuDNN path,
    and carrying the full [T,N] trajectory raised memory pressure and slowed the
    mjx physics). It also silently collapsed training via the t==0 normalization
    bug. With no speed benefit and equivalence already covered by the S0 parity
    gate, remove runner_scan.py, the --jax_scan_rollout flag, and slim
    jax_rollout.py to only what s0_parity needs.
2026-07-12 docs: align docs with step-by-step collection and current curriculum
    - README/CHANGELOG/design doc: drop stale JaxRollout one-shot scan
    references (feature was evaluated and not adopted into the mainline)
    - jax_rollout.py: remove removed-feature note, keep S0 parity description
    - rl/README.md: fix curriculum thresholds and terrain integration status
2026-07-12 feat(rl): add exploration guard against entropy collapse
    - Curriculum.update now returns upgrade/downgrade status (up/down/None)
    - DirectVecEnv reopens exploration (clamps std up to 0.15) when d_max advances,
    and raises entropy_coef (0.01->0.04) when mean noise_std drops below 0.03,
    reverting above 0.06 (hysteresis). Guard is inert unless runner injects
    runner.alg.policy / runner.alg references, so existing runs are unaffected.
    - Log entropy_coef and noise_std_guard to TensorBoard for monitoring.
    - AGENTS.md: document the guard.
2026-07-12 refactor(rl): relax curriculum upgrade gate to break d_max=0.1 plateau
    - upgrade_fall_rate 0.3 -> 0.5, fallback_fall_rate 0.5 -> 0.65 (dead band 0.5-0.65,
    no overlap so upgrade/downgrade cannot thrash at a boundary)
    - lets curriculum advance once ~50% of high-diff episodes survive to timeout instead
    of requiring 70%; the easiest difficulty no longer provides learning pressure once
    avg_survival is saturated near 1000
    - avg_survival >= 800 gate retained as a harmless redundant safeguard
2026-07-14 feat(rl): complete training stack for production PPO
    Schema v1.1.0 — wheel-odometry Actor observations, delayed prev_applied_action,
    D0 high-speed gate, reparameterized tanh entropy, 7-axis curriculum, CPU-first
    checkpoint resume, frozen S0-S7 scenario runner, pinned dependencies.
    Key changes:
    - Actor est_vx from wheel odometry (not root truth)
    - prev_applied_action is the delayed action sent to actuators
    - First-frame history [0,0,0,current] across MJX/native/Pi5
    - D0 command gated to 120mm at high speed in training
    - TanhGaussian: reparameterized entropy, stable log_prob Jacobian
    - init_noise_std 0.4, gamma 0.995, 96-step rollouts, 8 mini-batches
    - Roll gain ROLL_KP=190 mm/rad (geometri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
2026-07-14 fix(rl): align eval baseline with MJX wheel odometry and fix audit findings
    - eval_policy NativeBaseline now uses wheel-odometry x_est/xdot (was root truth)
    - MJX x_est persists across RL steps (was reset to x_ref, breaking LQI integral)
    - Pi5 sensor_age layout fixed to 3 IMU + 3 joint (was 1 + 5)
    - contract.py: removed stale GRU hidden_state field
    - eval_policy: Qx residual clipped before IK lookup (prevents ValueError)
    - eval_policy: D0 gate and residual scale constants from kuafu_physics
    - Removed duplicate WHEEL_R assignment and dead jax_rng restore
    - Removed unused OBS_DIM import in train.py
    - NUM_ENVS default 3072 (matches documented commands)
    - AGENTS.md: corrected curriculum module d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
    [serial_node.py]
2026-07-16 fix(bmi088): enable accelerometer via ACC_PWR_CTRL=0x04
    ACC_PWR_CTRL was written 0x03, which leaves the accelerometer inactive, so
    its data registers read all-zero. The Mahony filter then loses its gravity
    reference and pitch/roll cannot be corrected, breaking balance control.
    Per BMI088 datasheet (BST-BMI088-DS001, reg 0x7D), normal/active mode is
    selected by 0x04 (bit2). Verified on hardware via SWD: after the fix, accel
    z reads ~+9.8 m/s^2 when level and roll/pitch track the body tilt.
    Also add MDK-ARM/debug_tools/ with read_imu_state.py: a pyOCD/SWD script
    that non-intrusively reads the live IMU, gyro-bias, safety-state, and
    Mahony attitude globals (single connect-under-reset session)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
    [bmi088.c, read_imu_state.py]
2026-07-16 tools: add servo mechanical-zero calibration helper
    calib_servo_zero.py reads the live ST3215 present-position of all four hip
    servos via SWD while the firmware holds them torque-free (FAULT/SERVO locks
    servo torque off). The operator poses each leg at the dwell posture by hand;
    the script reports each servo's raw tick, which is the SERVO_CENTER[i] value
    to put in pin_config.h.
    Also fix both debug scripts to use target_override so pyOCD selects the
    STM32F407ZGTx pack (was falling back to a generic cortex_m target), and
    document the new tool in the debug_tools README.
    This corresponds to Bring-Up step 3 in docs/hardware/calibration.md.
    [calib_servo_zero.py, read_imu_state.py]
2026-07-16 fix(servo): drive ST3215 via full-duplex UART through Waveshare adapter
    The ST3215 hip servos connect through a Waveshare Bus Servo Adapter (A),
    which converts the single-wire half-duplex servo bus into a 2-wire UART.
    The firmware was using HAL_HalfDuplex_Init on PB10 only, so no servo ever
    replied (verified via SWD: every query hit the 3-failure FAULT_SERVO limit
    and position stayed at the zero init).
    Changes:
    - USART3 init: HAL_HalfDuplex_Init -> HAL_UART_Init, enable both PB10 (TX)
    and PB11 (RX) as AF push-pull. st3215_sync_write_pos/read_state already
    use the standard full-duplex HAL UART API, so no protocol change.
    - st3215_read_state: clear ORE / flush DR before reading the reply,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
    [main.c, pin_config.h, st3215.c]
2026-07-16 fix(servo): refresh IWDG during init and make FAULT torque-disable one-shot
    Two fixes for the full-duplex servo bus crashing ~9 s after boot:
    1. System_Initial_Setup now refreshes the IWDG between blocking init steps
    (IMU retry loop, DDSM commands, servo torque enable). Without this, slow
    UART blocking during init exceeded the ~512 ms watchdog window and reset the
    chip in a loop, which also made SWD unhalt-able.
    2. The STATE_FAULT branch disabled all 4 servo torques every 50 Hz cycle. In
    full-duplex each TX leaves echo bytes on RX; 4 packets x 50 Hz floods the bus
    and desyncs every subsequent read_state query, causing the all-servo crash.
    Made it one-shot via a static fla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
    [main.c]
2026-07-16 docs: move bring-up log out of docs/ into debug_tools/
    The dated bring-up log was mixing transient session notes with permanent
    reference docs in docs/hardware/. Reorganize so each location has one job:
    - docs/hardware/: permanent reference only — wiring.md (connections),
    calibration.md (procedure). No session logs.
    - debug_tools/: all debugging artifacts — README.md (now the full SWD debug
    reference: method, global address table, reliability notes, script usage),
    BRINGUP_LOG.md (the chronological session narrative, slimmed to findings/
    decisions/resume-checklist and pointing at README for method), and the two
    pyOCD scripts.
    No content lost: the SWD method/address-table/relia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
2026-07-16 fix(docs): update UART connection details for Pi5 and STM32
2026-07-16 docs: define STM32 firmware completion design
2026-07-16 docs: mark battery monitoring unavailable
2026-07-16 docs: plan STM32 firmware completion
2026-07-16 feat(firmware): record calibrated servo bring-up baseline
2026-07-16 refactor(firmware): isolate servo coordinate mapping
2026-07-16 feat(firmware): add timestamped device health
2026-07-16 feat(firmware): gate actuator enable through startup state
2026-07-16 feat(firmware): preserve continuous Pi UART DMA
2026-07-16 fix(firmware): require explicit wheel authorization
    [ddsm315.c, ddsm315.h, firmware_runtime.c, firmware_runtime.h, main.c, read_health.py, test_ddsm315.c, test_firmware_runtime.c]
2026-07-16 fix(firmware): continuously receive DDSM feedback
    [ddsm315.c, ddsm315.h, main.c, read_health.py, test_ddsm315.c]
2026-07-16 feat(firmware): complete STM32 hardware bring-up
2026-07-16 chore: export model_1650 (1650 updates, 170M steps, difficulty 0.60)
    S0 hold 40s pitch 1.97°, S1 vel max err 0.026, DR 20/20,
    S4 slopes ±10° 100%, S6 push 100% > baseline 87.5%.
    D0 tracking, stairs, full DR remain untrained.
2026-07-16 docs(architecture): sync control partition to deadline-bounded runtime
    Rewrite the Control Partition to match the firmware's four-layer
    deadline-bounded runtime, startup state machine, ten independent fault
    classes, five-condition wheel authorization gate, and asymmetric stale
    action/heartbeat degradation. Pointers to kuafu_physics.py,
    stm32_firmware/README.md, and contracts/interface.md replace the stale
    single-shutdown-path description. Clean rewrite, no patch voice.
2026-07-16 feat(teleop): wire gamepad teleop into the Pi5 serial loop
    Bluetooth/USB gamepad teleop runs as two processes linked by a Unix
    domain socket. The CommandArbiter (ramp/limit/estop/timeout safety layer)
    runs inside serial_node, so a teleop-process crash or dropped Bluetooth
    link degrades to the arbiter's safe default instead of holding the last
    command.
    - pi5_runtime/command_socket.py: shared length-prefixed JSON IPC protocol
    (AF_UNIX server + client, strict schema validation), no new dependency
    - rl/teleop/ipc_source.py: IPCCommandSource adapts socket frames to the
    CommandSource protocol; ESTOP frames transparently propagate
    - pi5_runtime/serial_node.py: --enable-teleop runs the arbiter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
    [serial_node.py]
2026-07-16 docs(architecture): add operating-modes table and CLIMB caveat
    Add a normative mode table to system.md mapping each RobotMode to its
    wheel-torque, leg-IK, and RL-residual behaviour, cross-checked against
    firmware_runtime.c (operational = STAND/ACTIVE/CLIMB; residual only in
    ACTIVE) and main.c. STAND and CLIMB both run the LQR/LQI baseline as a
    zero-velocity hold; only ACTIVE adds the learned residual. INIT locks
    wheels, FAULT zeroes them. Adds a CLIMB caveat: it is a reserved
    placeholder sharing STAND's code path, not trained in the RL policy.
    Mirrors a short note in stm32_firmware/README.md.
2026-07-16 feat(rl): 8-axis independent curriculum + heightfield rough terrain
    Replace the scalar d_max curriculum with an 8-axis independent state machine
    (rl/train/curriculum.py: AXES, DIFF_INDICES, AXIS_CONFIG). Axes
    command/d0/dr/latency/slope/step/rough/push each ramp independently; terrain and
    perturbation axes advance on a pure survival gate, while command/d0 keep a
    tracking anti-cheat gate calibrated above the measured noise floor. Difficulty is
    sampled per env in a band [0.8*level, level] per axis, and axes are evaluated by
    done-env episode count (no RSL-RL callback needed).
    Add a MuJoCo heightfield for rough terrain (DIFF_ROUGH). MJX 3.10.0 supports
    hfield x capsule collision (wheels are cap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
2026-07-16 feat(train): increase parallel environments to 4096 for improved training capacity
2026-07-16 docs(hardware): correct Pi5 serial device and JST pinout
    The Pi5 SoC PL011 behind the 3-pin JST debug connector enumerates as
    /dev/ttyAMA10. Update the default serial port, deployment commands, and
    wiring records to match.
    Record the verified JST pinout (Pin1=TX, Pin2=GND, Pin3=RX) in the wiring
    and architecture docs, and document the dialout group requirement for
    opening the device.
    Add pi5_runtime/link_probe.py, a model-free UART link tester that exercises
    the hello/heartbeat path and decodes STM32 telemetry for hardware bring-up.
    [link_probe.py, serial_node.py]
2026-07-16 fix(physics): stabilize model_hash across environments
    model_hash() folded the output of scipy.linalg.solve_discrete_are
    (LQR_K_DT4 / LQI_KI_DT4) into the digest via str(). These solved gains
    carry trailing-digit differences across scipy/Python versions, so the
    same physics produced different hashes on the training host versus the
    Pi5 — breaking the HELLO handshake and ONNX manifest validation.
    Hash only the deterministic inputs (plant parameters + Q/R weights +
    BASE_DT). The solved gains are still validated against golden values by
    verify_controller_golden.py. Regenerate kuafu_generated.h; the digest is
    now environment-independent.
    Extend the 0x84 health telemetry to 46 bytes with a per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
    [link_probe.py, main.c, pi_link.c, pi_link.h, protocol.py, test_pi_link.c]
2026-07-17 fix(firmware): add static forward declarations and fix health test offsets
    The DDSM error-breakdown helpers (Device_Timeout_Count /
    Device_Checksum_Count / Device_Protocol_Count) were defined after their
    first use in main.c, so add forward declarations to silence implicit-
    declaration warnings.
    The health-payload test asserted wheel_r_checksum at bytes [40:41], but
    the 46-byte layout places wheel_r_timeout there; wheel_r_checksum is at
    [42:43]. Fix the assertion offsets to match the encoder.
    [main.c, test_pi_link.c]
2026-07-17 feat(teleop): make gamepad axis mapping configurable
    Different gamepads (Flydigi, PS, Switch layouts) expose axes at different
    pygame indices. The hardcoded Xbox mapping (v=1/w=2/lt=4/rt=5) happened to
    match the Flydigi VADER2P evdev report, but there was no way to adapt
    without editing source.
    Add KUAFU_AXIS_V/W/LT/RT, KUAFU_BTN_ESTOP/MODE, and KUAFU_AXIS_V_INVERT
    environment variables to override the defaults at runtime. teleop_node
    prints the active mapping on startup so mismatches are obvious.
    Add 'python -m rl.teleop.gamepad_source --show-axes', a live probe that
    prints which axis index responds to each stick/trigger movement, so the
    correct override values can be determined for any c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
2026-07-17 fix(firmware): correct DDSM115 feedback velocity unit (10x error)
    ddsm_parse_feedback decoded the speed field as raw RPM, but the DDSM115
    protocol encodes speed in 0.1 RPM — the send side (ddsm_build_speed)
    already scales by 10 (raw = rpm*10), yet the receive side never divided
    it back out. Every wheel-velocity feedback was 10x too large.
    This destabilized the LQR hold: a wheel at rest, once slightly
    disturbed, reported ~33 rad/s. The controller then drove a braking
    torque against the phantom speed, crossed OMEGA_NOLOAD where
    limit_wheel_torque clamps to zero, and settled into a false steady-state
    spin near 3.3 rad/s (31 RPM) — exactly the 'wheel keeps spinning'
    symptom with the saturat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
    [ddsm315.c]
2026-07-17 fix(stm32): debounce freshness faults, grace window on mode transitions, and USART sub-error diagnostics
    - Add overrun/noise/framing counters to DeviceHealth_t and device_health_mark_uart_error().
    - Thread huart->ErrorCode through ddsm_bus_on_uart_error() to classify USART ORE/NE/FE.
    - Add freshness debounce (3 ticks) + 100ms mode-transition grace window in safety_state;
    hard faults (tilt/pitch/overtemp) still latch immediately.
    - Update read_health.py to decode new DeviceHealth_t and SafetyState_t layouts.
    - Expand host tests for debounce/grace and UART error sub-counters.
    - Host tests and Keil build pass 0 errors/0 warnings; flashed and verified on STM32.
    [ddsm315.c, ddsm315.h, device_health.c, device_health.h, main.c, pin_config.h, read_health.py, safety_state.c]
2026-07-17 feat(pi5): add --listen-only mode to link_probe for non-intrusive status checks
    - Add --listen-only flag: only decodes telemetry, sends no HELLO/heartbeat/ESTOP.
    - In active mode, behaviour unchanged; still sends ESTOP on exit.
    - Warn about port contention in help text so users do not steal the UART
    from an active controller.
2026-07-17 fix(audit): host test build, stale calibration metadata, and DDSM model comment
    - pi_link.c: fix GCC sign-compare warning promoted to error by -Werror
    - tests/CMakeLists.txt: link libm for kinematics math functions
    - tests/test_ddsm315.c: update velocity expectation after 0.1 RPM unit fix
    - rl/env/fivebar_ik_table.json: update embedded model_hash to current 9838e7fe323c1809
    - stm32_firmware/Core/Src/ddsm315.c: correct DDSM115 -> DDSM315 in comment
    [ddsm315.c, pi_link.c, test_ddsm315.c]
2026-07-17 fix(bmi088): retry init on I2C failure and recover locked bus
    - Add BMI088_MAX_INIT_ATTEMPTS retries: a failed I2C transaction restarts the
    init sequence instead of permanently latching BMI_INIT_FAILED.
    - Add bmi088_recover_bus(): DeInit + 9 SCL clocks as GPIO (AN3273 bus clear)
    + STOP + re-Init, releasing a slave that holds SDA low.
    - Fixes the soft-reset lockup where BMI088 stays in a bad state after an STM32-
    only reset (power-cycle was required); startup_manager already requested
    retries but they never recovered the I2C peripheral/bus.
    - Host tests: injectable I2C failures; retry-then-succeed and retry-exhausted
    cases. Fix stale DDSM115 velocity assertion (10x) from cc7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
    [bmi088.c, bmi088.h, ddsm315.c, test_bmi088.c, test_support.c, test_support.h]
2026-07-17 feat(teleop): explicit arm/disarm, stick shaping, hot-plug, haptics
    Operator control is now a two-state model: the source starts DISARMED
    (firmware STAND, LQR holds balance but wheels do not track commands and the
    RL residual is gated off) and must be explicitly armed before motion. This
    removes the old behavior where moving a stick instantly produced torque
    with no enable boundary.
    - gamepad/keyboard: START/Enter=arm->ACTIVE, Back/Backspace=disarm->STAND,
    A/Space=ESTOP latch (cleared by arm). State transitions emit rumble.
    - Stick pipeline is now deadzone then square curve (sign*|x|^gamma, gamma=2),
    so small deflections give precise low-speed control; triggers carry a
    deadzon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
2026-07-17 docs: rewrite to present-tense, fix 7->8 axis curriculum, reflect teleop model
    Normative documentation now states the current design directly instead of
    narrating change history.
    - README: curriculum is 8-axis (command/d0/dr/latency/slope/step/rough/push),
    not 7; add rl/teleop and the arm/disarm safety model to the architecture
    list; include rl/teleop/tests and the firmware CMake host tests in the
    standard verification block.
    - BRINGUP_LOG: state the wheel-authorization design in the present tense
    instead of describing the prior uncontrolled-motion bug it resolved.
    - CHANGELOG: restructured into present-tense control/firmware/teleop/
    runtime sections covering the DDSM unit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
2026-07-17 serial_node: add --no-policy mode for baseline-LQR teleop without ONNX
    --no-policy skips PolicyRuntime loading entirely and sends zero-action
    residual frames. The STM32 firmware treats absent/zero residual identically
    (residual_allowed=false), so the robot runs on the built-in 250 Hz LQR/LQI
    baseline alone — fully teleoperable without policy.onnx or its manifest.
    - SerialPolicyNode accepts model=None when no_policy=True
    - Sends HELLO frame directly (no PolicyRuntime dependency)
    - tick() constructs zero-action frames via command_frames()
    - set_command() guards runtime.reset() against None runtime
    - argparse validates --model required unless --no-policy set
    Docs: deployment.md gets a dedic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
    [serial_node.py]
2026-07-17 docs: Back→Select/Back for Flydigi VADER2P compatibility
    gamepad_source.py comment and deployment.md button-layout table /
    env-var table all now read 'Select/Back' instead of just 'Back'
    to reflect the actual button label on Flydigi controllers.
2026-07-17 teleop: interactive gamepad calibration (--calibrate)
    Replace the bare --show-axes axis monitor with a guided calibration tool
    that walks the operator through each stick, trigger, and button, auto-
    detects the v-axis invert direction, and prints ready-to-export
    KUAFU_AXIS_*/KUAFU_BTN_* lines. The old --show-axes mode is retained as
    a plain live monitor without guided prompts.
    Remove the standalone record_buttons.py debug script, whose 60-second
    button-event recording is fully covered by --calibrate and --show-axes.
    Update deployment.md to recommend --calibrate for new controllers.
2026-07-17 fix(curriculum): pin command axis to fixed full-range velocity commands
    The command (velocity) axis was curriculum-gated with a discrete level jump
    (v_limit 0.05→0.163 m/s, 3.25x) that caused per-env tracking-pass variance to
    collapse at level 1, producing level-0↔1 oscillation confirmed in training logs.
    Pin the command axis at max level with fixed full-range commands
    (V_CMD_RANGE/W_CMD_RANGE), matching legged_gym / MuJoCo Playground / RMA
    practice: velocity tracking is a foundational skill learned from step one under
    the LQR baseline, not a curriculum-gated axis. Add AxisConfig.pinned flag;
    pinned axes are initialized at max_level, never re-evaluated, and load_state_dict
    does not over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
2026-07-17 teleop: native gamepad calibration, remove pygame-based calibrator
    Add calibrate_native.py: reads /dev/input/js0 directly, bypassing
    pygame/SDL which drops events on Bluetooth LE gamepads (Flydigi VADER2P).
    The tool guides the operator through each stick, trigger, and button,
    captures the v-axis invert sign at detection time (not after spring-back),
    and prints ready-to-export KUAFU_AXIS_*/KUAFU_BTN_* lines.
    Remove the pygame-based _calibrate/_show-axes functions from
    gamepad_source.py; the module now only handles runtime polling.
    gamepad_source __main__ points users to calibrate_native.
    Fix V-axis invert bug: the old code re-read the axis after release and
    captured the spring-back overshoo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
2026-07-17 teleop: support inverted trigger axes (VADER2P RT)
    Flydigi VADER2P's RT trigger reports rest=+1 / press=-1 over Bluetooth,
    the opposite of the standard -1/+1 convention. normalize_trigger() now
    accepts an invert flag; gamepad_source reads KUAFU_AXIS_LT_INVERT and
    KUAFU_AXIS_RT_INVERT env vars and passes them through. The native
    calibration tool auto-detects trigger direction from the press sign and
    includes the invert vars in its exported output.
    Add 4 unit tests for inverted-trigger normalization. Update deployment.md
    env var table and calibration description.
2026-07-17 teleop: switch gamepad axis/button reading to native /dev/input/js0
    pygame's get_axis()/get_button() can return stale cached values on
    Bluetooth LE devices (SDL 2.28.4 does not reliably flush joystick state
    between event pumps). This manifested as --show-axes dropping most
    events while calibrate_native (direct js0 read) captured all of them.
    Add _NativeJoystick class that reads /dev/input/js0 directly — the same
    path calibrate_native.py uses — and maintains up-to-date axis/button
    state. GamepadSource.poll() now reads from _NativeJoystick instead of
    pygame's methods. Pygame is retained only for joystick enumeration,
    hotplug events (JOYDEVICEADDED/REMOVED), and haptic feedback.
    _calibrat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
2026-07-17 serial_node: add startup and heartbeat logging
    Previously serial_node printed nothing at all, making it impossible to
    tell whether it started, whether the serial port opened, or whether
    telemetry was flowing. Add startup banners (port, policy mode, arbiter
    status), a one-shot 'first telemetry' confirmation, and a periodic
    (~5s) heartbeat log that shows tick count and current command.
2026-07-17 teleop: BLE gamepad idle-sleep detection and watchdog
    Problem: Flydigi VADER2P and similar BLE gamepads enter a low-power
    idle state after Bluetooth connection and stop sending HID input
    reports until physically operated. The kernel /dev/input/js0 device
    exists and INIT events arrive, but no real-time events flow. This
    caused --show-axes to appear broken and GamepadSource to never see
    button/stick input.
    Solution:
    - _NativeJoystick now tracks event_count and idle_seconds to detect
    when the gamepad stops sending data.
    - GamepadSource._check_idle() prints periodic wake-up reminders and,
    when KUAFU_BT_MAC is set, triggers a bluetoothctl reconnect after
    KUAFU_IDLE_RECONNECT seconds (defau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
2026-07-17 serial_node: restore HELLO in no-policy mode
    Without HELLO the firmware sets link_compatible=0 and silently drops
    all HEARTBEAT frames, so mode commands never reach the STM32 and the
    robot stays stuck in STAND regardless of what the teleop sends.
    The earlier telemetry=waiting issue was caused by multiple processes
    opening the same serial port, not by HELLO itself. Confirmed by
    single-process test: HELLO + heartbeat yields full telemetry flow
    and the firmware transitions STARTUP→STAND correctly.
    [serial_node.py]
2026-07-17 pi5_runtime: single-process teleop entry point (teleop_single)
    When serial_node and teleop_node run as separate processes they compete
    for the same UART (/dev/ttyAMA10), causing heartbeat frames to be dropped
    (the STM32 never sees heartbeat_fresh and refuses STAND->ACTIVE) or serial
    reads to fail with 'multiple access on port'.
    teleop_single combines gamepad reading, the serial link, and command
    sending into one process with exactly one serial fd and one js0 fd.
    Verified end-to-end: HELLO accepted, STAND->ACTIVE transition succeeds,
    no FAULT.
    Usage:
    PYTHONPATH=. python -m pi5_runtime.teleop_single
    Reads the same KUAFU_AXIS_*/KUAFU_BTN_* env vars as gamepad_source.
    [teleop_single.py]
2026-07-17 teleop: consolidate to single-process architecture, remove dead code
    The multi-process teleop architecture (serial_node + teleop_node + IPC
    socket + arbiter + multiple CommandSource classes) was replaced by
    teleop_single.py in the previous commits. This change removes all the
    dead code that is no longer imported by any active path.
    New module:
    - rl/teleop/native_joystick.py — NativeJoystick class extracted from the
    inline code in teleop_single.py and calibrate_native.py. Single source
    of truth for /dev/input/jsX reading.
    Removed (10 files, ~1700 lines):
    - rl/teleop/gamepad_source.py — pygame-based GamepadSource (superseded)
    - rl/teleop/pygame_base.py — pygame bootstrap (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
    [serial_node.py, teleop_single.py]
2026-07-17 fix(stm32): zero wheel torque during startup discovery
    DDSM315 motors in CURRENT mode retain the last torque command across STM32-only
    resets. On startup, after setting the wheel mode to CURRENT, immediately send a
    zero-torque command before disabling the motor, so stale torque from a previous
    session cannot keep the wheels spinning.
    Also gate wheel dispatch on g_actuator_configured (rather than step >= 4U) so
    discovery commands own the bus until all init frames are sent.
    [main.c]
2026-07-17 teleop_single: add ser.flush() + delay after HELLO
    Without flush(), the HELLO frame may still be in the UART TX buffer when
    the first heartbeat arrives, causing the STM32 to see the heartbeat before
    HELLO (link_compatible stays 0 and STAND→ACTIVE never happens).
    Add ser.flush() to wait until HELLO is fully transmitted, plus a 300ms
    delay to let the STM32 firmware process it before heartbeats start.
2026-07-17 teleop_single: debug - print TX heartbeat bytes when mode changes
2026-07-17 fix(stm32): auto-accept Pi link on first valid heartbeat, zero wheel torque on startup
    pi_link: accept the first well-formed heartbeat as implicit proof of protocol
    compatibility (set link_compatible=1) when no explicit HELLO has been seen,
    so Pi can reconnect after an STM32-only reset without resending HELLO.
    main: send zero-torque to DDSM wheels after setting CURRENT mode during
    actuator discovery, clearing stale torque retained across STM32-only resets.
    main: gate wheel dispatch on g_actuator_configured and revert DMA init to
    the simple HAL call (DMA was working; earlier register writes were chasing
    a pyOCD offset error).
    [pi_link.c]
2026-07-17 fix(stm32): LQR wheel direction, torque polarity, and self-balance robustness
    Self-balance (STAND mode) no longer requires a Pi connection:
    - wheel_authorized is gated on STARTUP_READY + !FAULT only;
    - wheel_intent_allowed no longer requires wheel_bus_idle so the
    LQR runs every 250 Hz deadline regardless of bus phase.
    Right motor physical mirror and DDSM torque polarity:
    - WHEEL_DIR_R = -1 (right motor is mounted mirrored);
    - LQR output is negated to match DDSM315 +torque = body-backward;
    - yaw-differential formula updated for the mirror + polarity.
    Pitch-gated torque fade (20-50 deg) and anti-windup at 50 deg
    prevent runaway wheel spin when the robot falls.
    FAULT s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
    [ddsm315.h, firmware_runtime.c, lqr_controller.c, main.c, pin_config.h, test_ddsm315.c, test_firmware_runtime.c]
2026-07-27 fix(stm32): ground-standing robustness - DMA servo RX, stillness-gated gyro calib, airborne re-anchor
    [bmi088.c, ddsm315.c, ddsm315.h, kuafu_balance_trace.py, kuafu_boot_trace.py, kuafu_fault_dump.py, kuafu_freeze_catch.py]
2026-07-27 fix(stm32): DDSM315 current-loop mode frame + no-reply fault latch
    [ddsm315.c, ddsm315.h, main.c, pin_config.h, st3215.h, test_ddsm315.c, test_st3215.c]
2026-07-27 fix(stm32): self-recovering startup and auto-clearing freshness faults
    [safety_state.c, startup_manager.c, test_safety_state.c, test_startup_manager.c]
2026-07-27 fix(stm32): decouple balancing from gyro calibration
    [main.c, safety_state.c, startup_manager.c, test_startup_manager.c]
2026-09-13 stm32: single 250Hz control section with persistent wheel-output gate
    Rebuild the firmware's safety composition around one wall-clock control
    deadline. The sequence safety state machine -> actuator-supervisor
    verdict -> wheel output gate -> LQR -> balance trace now lives in a
    host-testable control_section module; the bus dispatch that follows
    obeys the same persistent gate, so a denial and every command derived
    from it are ordered within one control period (the previous layout let
    a per-iteration intent copy override the verdict within ~1 ms).
    - Actuator supervisor is the final output verdict; ops-less integration
    authorizes only after the servo-enable verified flag drops and returns
    on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
2026-09-13 rl: timing/contract consistency with the firmware (schema v1.2.0)
    Align the simulation-side controller and policy contract with the
    firmware's delivered control timing: alternating 8 ms per-wheel refresh
    on the 4 ms bus with phase offset, held feedback between valid updates,
    the shared LQI integral clamp (0.05 baseline), final D0 gating order,
    and a single provisional Nm/raw torque conversion source mirrored from
    kuafu_physics.py into the regenerated header.
    - rl/verify/verify_control_timing.py: bounded host verification of the
    bus schedule, held feedback, delay/jitter envelopes, D0 gating and
    torque conversion (27 cases).
    - rl/env/contract.py: SCHEMA_VERSION v1.2.0 — the timing/sign/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
2026-09-13 docs: control-section architecture, validation record, mode-scoped command contract
    - HANDOFF: refresh the SWD symbol table for the new layout (adds
    g_wheel_output_gate / g_control_section / ring symbols), document the
    single 250 Hz control section, the ACTIVE-only velocity contract, the
    RX-ring producer reconstruction, and the resolved ACC_CONF decoding.
    - docs/validation/stm32-firmware-2026-09-11.md: record the delivered
    state of the repair sprint — supervisor verdict integration (including
    the integration-review finding that the first pass was overridable and
    the ops-less authorization fix), lap-based ring accounting, host/Keil
    evidence, and the open hardware gates. No mot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
2026-09-16 fix(stm32): two-pass logic review - supervision lifecycle, freshness gates, bus-write reliability
    2026-09-13 round:
    - actuator_supervisor: fix cold-boot deadlock in the ops-less enable-reissue
    stage (startup_ready and servo_enable_verified flip together in the
    scheduler; low observations are now latched on every step, and the
    drop-requirement re-arms only on revocation from READY)
    - main: wheel enable requires an operational mode; INIT keeps the wheel
    domain locked to read-only queries
    - control_section: LQR estimation authority additionally requires IMU pair
    freshness so a dead DRDY line revokes torque at the 20 ms bound
    - st3215: UART error handling deferred from ISR to the main-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
    [actuator_supervisor.c, actuator_supervisor.h, control_section.c, control_section.h, firmware_runtime.c, firmware_runtime.h, main.c, safety_state.c]
2026-09-16 fix(pi5): heartbeat continuity, decoder resync, and link-probe fault table
    - teleop_single: mirror the firmware's dynamic D0 gate before encoding --
    with the legs raised, fast stick input failed validation every tick and
    silenced the heartbeat stream exactly during aggressive motion until the
    200 ms watchdog demoted the robot; the TX error path now falls back to a
    safe STAND heartbeat instead of silence, a lost gamepad no longer
    replays its last stick values, a blocking BLE reconnect first forces
    disarm, the exit ESTOP is flushed before close, HEALTH frames are
    length-guarded, and the status/idle printers no longer share a throttle
    - protocol: StreamDecoder resynchronizes after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
    [link_probe.py, protocol.py, serial_node.py, teleop_single.py]
2026-09-16 docs: validation records for the 09-13/09-16 reviews, handoff refresh, schema v1.2.0 references
    - add docs/validation/stm32-firmware-2026-09-13.md and
    stm32-firmware-2026-09-16.md (full review method, defect lists, fix
    rationale, verification evidence, flash gate)
    - HANDOFF: restructure the review log (newest first, both rounds),
    document the grace-window scope and the servo-deadline retry, refresh
    the SWD symbol-table check (addresses unchanged by the new build)
    - interface.md: Pi wire behaviour on stale telemetry and peer sequence
    restart; HELLO-or-first-valid-heartbeat compatibility rule
    - system.md: startup chain without the unused GYRO_CALIBRATION phase,
    three-condition whee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
2026-09-20 fix(stm32): three-pass logic review - fault lifecycle, bus completion self-heal, calibration latches
    - gate the servo enable sequencer on mode != FAULT: a mode-blind sequencer
    re-armed torque during FAULT and re-set servos_enabled while the one-shot
    disable was releasing it, so a transient-fault recovery reopened the wheel
    gate on physically torque-free legs
    - re-validate the DDSM timeout verdict under the bus IRQ mask (phase +
    deadline), closing the one main-context phase transition the concurrency
    contract left uncovered; stamp last_tx.finished_ms on the timeout path
    - give ST3215 write frames a 20 ms deadline plus an explicit AbortTransmit
    recovery, so a lost TX-complete costs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
    [bmi088.c, control_section.c, ddsm315.c, main.c, pi_link.c, st3215.c, st3215.h, startup_manager.h]
2026-09-20 docs: 2026-09-20 review record, fault-model corrections, handoff refresh
    - docs/validation/stm32-firmware-2026-09-20.md: consolidated record of the
    09-19/20 three-pass review (10 findings, verification evidence, kept
    design decisions)
    - system.md: describe the fault model as it is - serious faults latch until
    reset, the three transient device faults recover through the supervisor's
    re-issue stage
    - firmware README: FAULT-gated enable sequencer contract, real-first-frame
    servo freshness, write-frame deadline/abort self-heal
    - HANDOFF: review log entry, address-table revalidation, date stamps
2026-09-20 fix(stm32): zero-torque dispatch whenever the wheel gate closes on an enabled motor
    The DDSM315 current loop holds its last setpoint, so a read-only query on
    a gate-closed but still-enabled wheel leaves the pre-closure LQR torque
    actively driving the robot. That state is reachable with an operational
    mode: an actuator-supervisor HOLDING demotion (e.g. the 100 ms leg-hold
    window expiring under servo-bus congestion) keeps STAND/ACTIVE while the
    gate is closed, and the only backstop was the 45-degree TILT fault after
    the robot had effectively fallen.
    Dispatch now sends an explicit zero-torque frame in any mode whenever the
    gate is closed and the wheel remains enabled; plain queries are reserve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
    [main.c, test_ddsm315.c]
2026-09-20 docs: whole-system review record and coherent dispatch/safety documentation
    Adds the 2026-09-20 second-review validation record: a from-source audit
    that re-derived every module without the prior review records, machine-
    verified the physics->LQR->codegen chain (verify_physics_source 28/28,
    controller golden, artifact byte-check, 108 pytests), and re-proven
    toolchain facts (linker image ends 0x2001FFBF protecting the forensic
    RAM top, 4 KB stack vs ~0.8 KB deepest frame, HAL clock/priority config).
    One defect found and fixed (previous commit); three design decisions
    documented as known behaviour: telemetry silence while the IMU path is
    down, diagnostic-only DDSM feedback mode byte, frozen LQ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
2026-09-20 fix(stm32): fifth-pass logic review - write-frame abort on all failure paths, lap-preserving RX re-arm, wall-clock diagnostics
    - ST3215 write frames (sync-write/torque) recover through an explicit
    transmit abort on BOTH failure paths: a lost TX-complete interrupt
    (20 ms deadline) and a UART error during the write (error_pending).
    Either path skipping the abort can wedge the HAL TX state at BUSY_TX
    forever: all leg writes then fail HAL_BUSY, the 100 ms leg-hold window
    expires, the wheel gate closes, and the deadline backstop is disarmed
    because phase is already IDLE. Regression in test_st3215.c.
    - Circular RX-ring re-arms preserve the lap truth: new
    dma_rx_ring_rebase() anchors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
    [balance_trace.c, dma_rx_ring.c, dma_rx_ring.h, main.c, pi_link.c, st3215.c, test_balance_trace.c, test_dma_rx_ring.c]
2026-09-20 docs: fifth-pass review record; telemetry split, re-arm semantics, and boot marker as current-state documentation
    - docs/validation/stm32-firmware-2026-09-20-3.md: full record of the
    independent fifth-pass review (method, six findings with rationale,
    verified-clean list, deliberate decisions left unchanged, evidence).
    - system.md: layer 4 is now the wall-clock diagnostic layer; layers 1-3
    remain DRDY-paced.
    - HANDOFF: review-history entry for this round; §7.5 states the
    telemetry split (state frames DRDY-paced, diagnostics wall-clocked);
    RX-ring re-arm described as lap-preserving; the superseded
    telemetry-silence limitation removed from the known-constraints list.
    - stm32_firmwa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
2026-09-20 fix(stm32): sixth-pass logic review - RX sequence-gate peer-restart resync, non-finite encoder guards
    - pi_link receive gate resynchronizes after 8 consecutive CRC-valid,
    non-HELLO frames rejected by the monotonic gate alone (firmware mirror
    of the Pi-side StreamDecoder resync): a rebooted Pi whose single
    startup HELLO was corrupted on the wire is no longer locked out of
    ACTIVE until an STM32 power cycle. The reject counter is packed into
    the existing have_rx_sequence state byte, so no data symbol is added
    and the SWD debug-script address table stays valid.
    - ddsm_build_torque/ddsm_build_speed decode a non-finite command as zero
    torque instead of an undefined float-to-int cast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
    [ddsm315.c, pi_link.c, servo_mapping.c, test_ddsm315.c, test_pi_link.c, test_servo_mapping.c]
2026-09-20 docs: sixth-pass review record; link sequence-gate resync and encoder guards as current-state documentation
2026-09-20 fix(stm32): seventh-pass logic review - shared-stamp IMU pair, init retry contract, sliced RX decode, mode-request totality
    - BMI088: one fusion cycle reads accel+gyro under a single caller timestamp
    (bmi088_read_pair). The aggregate health pair check previously compared two
    independently sampled HAL_GetTick() values, so a main loop phase-locked to a
    millisecond boundary never refreshed it: imu_fresh went false, the 32 ms
    debounce latched FAULT_IMU (serious, power-cycle only) and bricked the robot
    while both sensor channels were healthy. The "only a real pair counts"
    semantics is preserved - a failed channel still leaves it unrefreshed.
    - BMI088 init: BMI_INIT_GYRO_MAP now follow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
    [bmi088.c, bmi088.h, main.c, pi_link.c, safety_state.c, test_bmi088.c, test_pi_link.c, test_safety_state.c]
2026-09-20 docs: seventh-pass review record; IMU pair semantics, RX slicing, and mode-request totality as current-state documentation
    - New validation record docs/validation/stm32-firmware-2026-09-21.md: the
    independent seventh pass (architecture / detail / contract), the three fixed
    findings ranked by severity with their regressions, and the reviewed-and-kept
    list (transient-fault entry needs no LQR re-anchor because the closed wheel
    gate freezes x_est; CLIMB reachable only through ACTIVE; heartbeat-fallback
    link compatibility; the supervisor LATCHED terminal state).
    - stm32_firmware/README.md: the BMI088 runtime bullet now states that a fusion
    cycle stamps both channels with one caller-su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
2026-09-20 fix(stm32): eighth-pass logic review - Pi RX transport overrun recovery, trace freeze release, LQR non-finite coast
    - pi_transport_poll derived its parse span from a read_index-vs-write_index
    comparison; after an overrun drop the two coincide while a full ring is
    pending, so the consumer stalled exactly one ring behind the producer
    forever, billing every fresh byte as another overrun and parsing nothing
    (permanent Pi-link receive deafness after any >2.2 ms main-loop stall).
    The span now comes from the absolute produced/consumed cursors clamped to
    one ring, the still-valid remainder is parsed in the same poll, and the
    laps/NDTR sampling race is harmless by construction.
    - balanc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
    [balance_trace.c, balance_trace.h, kuafu_balance_trace.py, kuafu_boot_trace.py, kuafu_watch.py, lqr_controller.c, pi_transport.c, pi_transport.h]
2026-09-20 docs: eighth-pass review record; transport recovery, trace freeze release, and SWD rebaseline as current-state documentation
    - docs/validation/stm32-firmware-2026-09-20-5.md: the eighth-pass record
    (scope/method, three findings with root causes and fixes, retained
    bounded residuals, verification evidence).
    - HANDOFF.md: new review section in the log, the RX-ring overrun and
    balance-trace freeze semantics updated to current behaviour, and the
    SWD symbol table rebased to the new map (11 symbols +4).
    - stm32_firmware/README.md and CHANGELOG.md: the same three changes as
    current-state documentation.
